gigi74168/openKVM/docs/00-decision-architecture.md

# 00 — Décision d'architecture : ESP32-P4 en 10/100 Mbit/s

Date : 2026-11-12 — statut : **validée**

## Le conflit
- Exigence initiale : RJ45 **Gigabit** + fork du firmware JetKVM Mini (ESP32-P4, MIT).
- L'ESP32-P4 n'a qu'un MAC 10/100 (MII/RMII ; ESP-IDF ne gère que le RMII). Son unique port USB HS
  est réservé à la machine cible, donc pas d'adaptateur USB→GbE.
- Le RV1106 (JetKVM original, GPL-2.0) est **lui aussi** limité à 10/100 (MAC + PHY intégré, RMII).
- Le Gigabit impose un autre SoC (ex. RV1126B : GMAC RGMII 1G) avec DDR + eMMC + BGA, PCB 6 couches
  probable et coût incompatible avec l'objectif < 39 $.

## Décision
- **v1 : ESP32-P4 + PHY 10/100**, fork de `jetkvm/mini` (MIT, copyright d'origine conservé).
- Exigence « RJ45 Gigabit » remplacée par « RJ45 10/100 ».
- Piste **v2 « Pro » Gigabit** (RV1126B + RTL8211F, portage de `jetkvm/kvm` GPL-2.0) : documentée, hors périmètre.

## Pourquoi le Gigabit était voulu : envoi rapide d'ISO
- 100 Mbit/s ≈ 11 Mo/s théoriques → ISO de 5 Go ≈ 8 min (estimation, à mesurer au bring-up).
- Mitigations à étudier (livrables 2, 7 et 8) :
  - slot microSD accessible de l'extérieur pour copier l'ISO directement depuis un PC ;
  - bibliothèque d'ISO persistante sur la carte (on n'envoie une image qu'une fois) ;
  - upload reprenable, en arrière-plan ;
  - mesure du débit SDIO réel du P4 et du débit USB Mass Storage vers la cible.

## Décision complémentaire (2026-11-12) : version sans écran

Le brief initial demandait le même écran IPS 240 × 240 que le Mini. **Cette exigence est abandonnée** à ta demande :
openKVM v1 n'a **aucun écran**.

| Avant | Maintenant |
|---|---|
| Écran IPS 1,54″ ST7789 sur connecteur J7, 6 GPIO | Supprimé, les 6 GPIO sont libres |
| 2 boutons latéraux (navigation, mode) | 1 bouton latéral « FN » (réinitialisation réseau / usine) |
| 1 LED de debug | 1 LED d'alimentation + 1 LED d'état |
| Boîtier ≈ 49,6 × 49,6 × 26,5 mm, capot à fenêtre | ≈ 49,6 × 49,6 × 21,5 mm, capot plein |
| Module d'écran à acheter et à monter à la main | Plus rien hors assemblage JLCPCB, sauf le TC358743 à fournir |

Conséquences :
- L'adresse IP ne s'affiche plus. Le firmware (livrable 8) devra annoncer l'appareil par **mDNS** et par nom d'hôte DHCP.
- Le fork de `jetkvm/mini` devra **retirer le pilote d'écran** et piloter la LED d'état à la place.
- C'est un écart assumé par rapport au Mini, qui garde son écran. En échange : moins cher, plus bas, plus simple à monter.

## Sources
- JetKVM Mini — https://jetkvm.com/blog/introducing-jetkvm-mini
- jetkvm/mini (MIT, ESP-IDF 6.0.2, IP101, TC358743) — https://github.com/jetkvm/mini
- jetkvm/kvm (GPL-2.0) — https://github.com/jetkvm/kvm
- ESP32-P4 Features (Zephyr) — https://docs.zephyrproject.org/latest/boards/espressif/common/soc-esp32p4-features.html
- ESP-IDF esp_eth ESP32-P4 — https://docs.espressif.com/projects/esp-idf/en/v5.4.3/esp32p4/api-reference/network/esp_eth.html
- Rockchip RV1106 Datasheet V1.7 — https://rockchips.net/wp-content/uploads/2025/03/Rockchip-RV1106-Datasheet-V1.7-20231218.pdf
- Forlinx OK1126B-S Hardware Manual — https://docs.forlinx.net/rockchip/ok1126bx-s/OK1126B-S_OK1126BJ-S_User_Hardware_Manual.html
