gigi74168/openKVM/hardware/exports/netlist.csv

Net | Nb | Broches
1V2 | 8 | L2.2 R9.1 C10.1 C12.1 C13.1 FB1.1 FB2.1 FB3.1
3V3 | 49 | L1.2 R6.1 C5.1 C7.1 C8.1 C9.1 R8.1 U1.9 U1.21 U1.62 U1.75 U1.77 U1.96 U1.101 C14.1 C15.1 C16.1 C17.1 C18.1 C19.1 C20.1 C21.1 R11.1 R12.1 U2.4 C47.1 R20.1 R21.1 R23.1 R25.1 R26.1 TP1.1 U8.F4 U8.H7 R34.1 C70.1 C71.1 FB5.1 U9.13 R36.1 R37.1 R40.1 R41.1 C73.1 FB6.1 J4.9 R55.1 Q1.2 R56.1
5V_SYS | 10 | U3.6 U4.6 C3.1 C4.1 U5.4 R5.1 C6.1 U6.4 C11.1 R22.1
BTN_FN | 3 | U1.25 SW1.3 R23.2
CHIP_PU | 4 | U1.103 R20.2 C52.1 TP4.1
CSI_CLK_N | 2 | U1.45 U8.C7
CSI_CLK_P | 2 | U1.44 U8.C8
CSI_D0_N | 2 | U1.42 U8.E7
CSI_D0_P | 2 | U1.43 U8.E8
CSI_D1_N | 2 | U1.46 U8.D7
CSI_D1_P | 2 | U1.47 U8.D8
CSI_REXT | 2 | U1.48 R14.1
DSI_REXT | 2 | U1.34 R13.1
EN_1V2 | 2 | U6.1 R8.2
EN_3V3 | 2 | U5.1 R5.2
EN_DCDC | 2 | U1.79 U2.1
ETH_AVDD33 | 4 | U9.31 FB6.2 C74.1 C75.1
ETH_CLKO | 2 | U9.14 R39.1
ETH_CT_RX | 2 | J4.5 C81.1
ETH_CT_TX | 2 | J4.4 C80.1
ETH_ISET | 2 | U9.25 R38.1
ETH_LED0 | 3 | U9.11 R37.2 R42.2
ETH_LED3 | 2 | U9.12 R43.1
ETH_LEDG_K | 2 | J4.10 R42.1
ETH_LEDY_A | 2 | J4.12 R43.2
ETH_REGOUT | 3 | U9.28 C76.1 C77.1
ETH_RMII_SEL | 2 | U9.4 R36.2
ETH_RX_N | 2 | U9.26 J4.6
ETH_RX_P | 2 | U9.27 J4.3
ETH_TX_N | 2 | U9.29 J4.2
ETH_TX_P | 2 | U9.30 J4.1
ETH_X1 | 3 | U9.2 Y3.1 C78.1
ETH_X2 | 3 | U9.3 Y3.3 C79.1
FB_1V2 | 4 | U6.5 R9.2 R10.1 C10.2
FB_3V3 | 4 | U5.5 R6.2 R7.1 C5.2
FB_DCDC | 5 | U1.78 U2.5 R15.2 R16.1 C46.2
FLASH_CK | 2 | U1.32 U7.6
FLASH_CS | 3 | U1.27 U7.1 R19.2
FLASH_D | 2 | U1.33 U7.5
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
VDD_BAT | 4 | U1.102 R11.2 C22.1 C23.1
VDD_HP | 13 | U1.26 U1.54 U1.76 U1.91 C27.1 C28.1 C29.1 C30.1 C31.1 L3.2 R15.1 C46.1 C48.1
VDD_USBPHY | 5 | U1.51 R12.2 C24.1 C25.1 C26.1
XTAL_A | 3 | Y1.1 R17.1 C49.1
XTAL_B | 3 | Y1.3 R18.1 C50.1
XTAL_N | 2 | U1.99 R18.2
XTAL_P | 2 | U1.100 R17.2
