gigi74168/openKVM/hardware/exports/placement.csv

ref | face | x_mm | y_mm | rotation
C1 | dessus | 43.00 | 9.60 | 270
C10 | dessous | 13.00 | 35.60 | 180
C11 | dessus | 11.40 | 35.00 | 90
C12 | dessus | 14.40 | 35.40 | 180
C13 | dessus | 14.00 | 33.60 | 0
C14 | dessous | 33.20 | 31.80 | 90
C15 | dessous | 20.00 | 37.00 | 270
C16 | dessous | 21.60 | 37.80 | 270
C17 | dessous | 27.00 | 37.80 | 270
C18 | dessous | 27.80 | 33.60 | 90
C19 | dessous | 35.20 | 32.60 | 0
C2 | dessus | 9.20 | 26.20 | 90
C20 | dessous | 34.00 | 28.80 | 0
C21 | dessous | 34.80 | 30.80 | 270
C22 | dessous | 29.40 | 37.60 | 180
C23 | dessous | 25.20 | 31.40 | 90
C24 | dessus | 18.80 | 27.80 | 180
C25 | dessus | 17.40 | 29.20 | 180
C26 | dessous | 23.20 | 24.40 | 0
C27 | dessous | 19.80 | 26.20 | 90
C28 | dessous | 23.00 | 37.80 | 270
C29 | dessous | 25.60 | 37.80 | 270
C3 | dessous | 7.40 | 41.20 | 0
C30 | dessus | 36.40 | 42.40 | 270
C31 | dessous | 35.20 | 24.80 | 0
C32 | dessous | 27.80 | 28.20 | 270
C33 | dessous | 17.20 | 33.20 | 180
C34 | dessous | 36.80 | 29.40 | 0
C35 | dessous | 17.80 | 27.80 | 180
C36 | dessous | 25.20 | 29.20 | 90
C37 | dessous | 17.20 | 34.60 | 180
C38 | dessous | 18.20 | 26.00 | 90
C39 | dessous | 27.60 | 30.40 | 270
C4 | dessus | 12.60 | 41.20 | 0
C40 | dessous | 18.60 | 37.00 | 270
C41 | dessous | 23.80 | 22.80 | 180
C42 | dessus | 19.20 | 37.00 | 270
C43 | dessus | 21.20 | 23.20 | 270
C44 | dessous | 16.80 | 36.00 | 180
C45 | dessous | 24.20 | 40.00 | 270
C46 | dessus | 28.40 | 40.00 | 0
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
TP3 | dessous | 19.60 | 34.60 | 0
TP4 | dessous | 32.40 | 38.00 | 0
TP5 | dessous | 17.20 | 31.20 | 0
TP6 | dessous | 28.40 | 42.40 | 0
U1 | dessus | 26.50 | 31.00 | 180
U10 | dessus | 22.75 | 12.50 | 0
U11 | dessus | 25.75 | 12.50 | 0
U12 | dessus | 29.20 | 12.50 | 0
U13 | dessus | 39.50 | 10.20 | 0
U14 | dessus | 9.90 | 31.00 | 90
U2 | dessus | 33.50 | 39.50 | 0
U3 | dessus | 6.60 | 42.30 | 0
U4 | dessus | 10.20 | 42.30 | 0
U5 | dessus | 4.60 | 38.30 | 0
U6 | dessus | 12.60 | 38.30 | 0
U7 | dessus | 37.00 | 33.00 | 0
U8 | dessus | 26.00 | 18.50 | 270
U9 | dessus | 13.60 | 25.20 | 0
Y1 | dessus | 18.80 | 32.80 | 90
Y2 | dessus | 20.40 | 18.50 | 0
Y3 | dessus | 18.60 | 24.60 | 90
