gigi74168/openKVM/hardware/exports/openkvm-schema.pdf

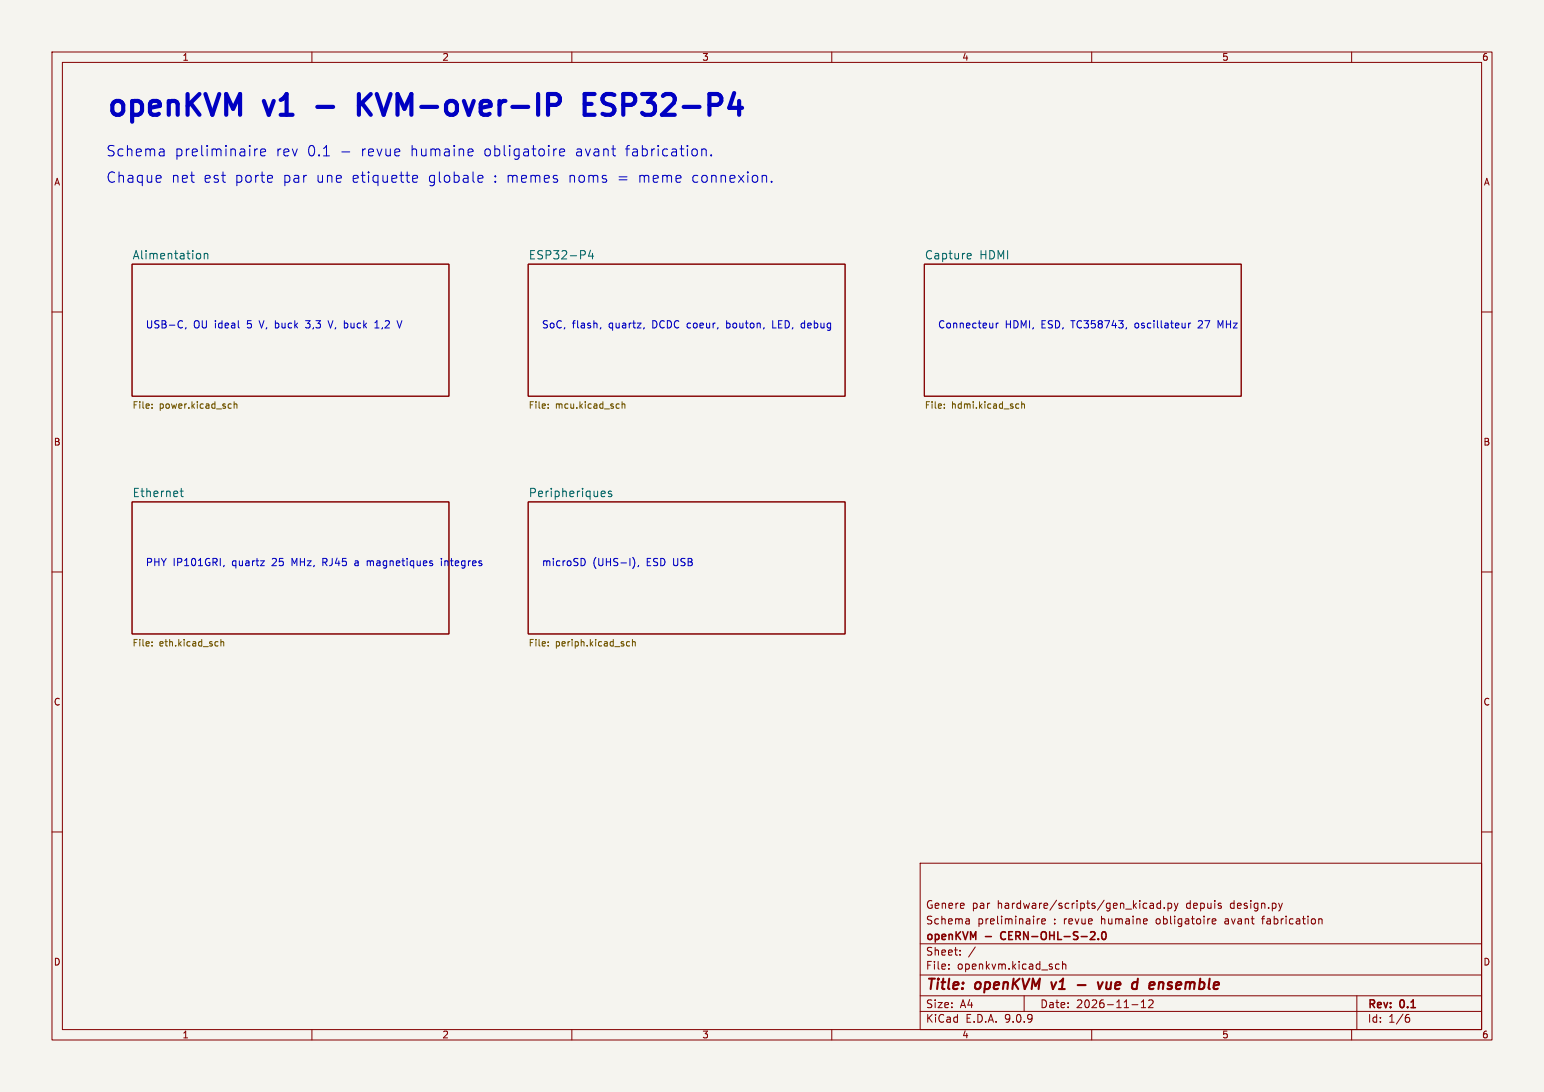
[picture p15: page 1]

USB-C, OU ideal 5 V, buck 3,3 V, buck 1,2 V

Id: 1/6 Title: openKVM v1 - vue d ensemble

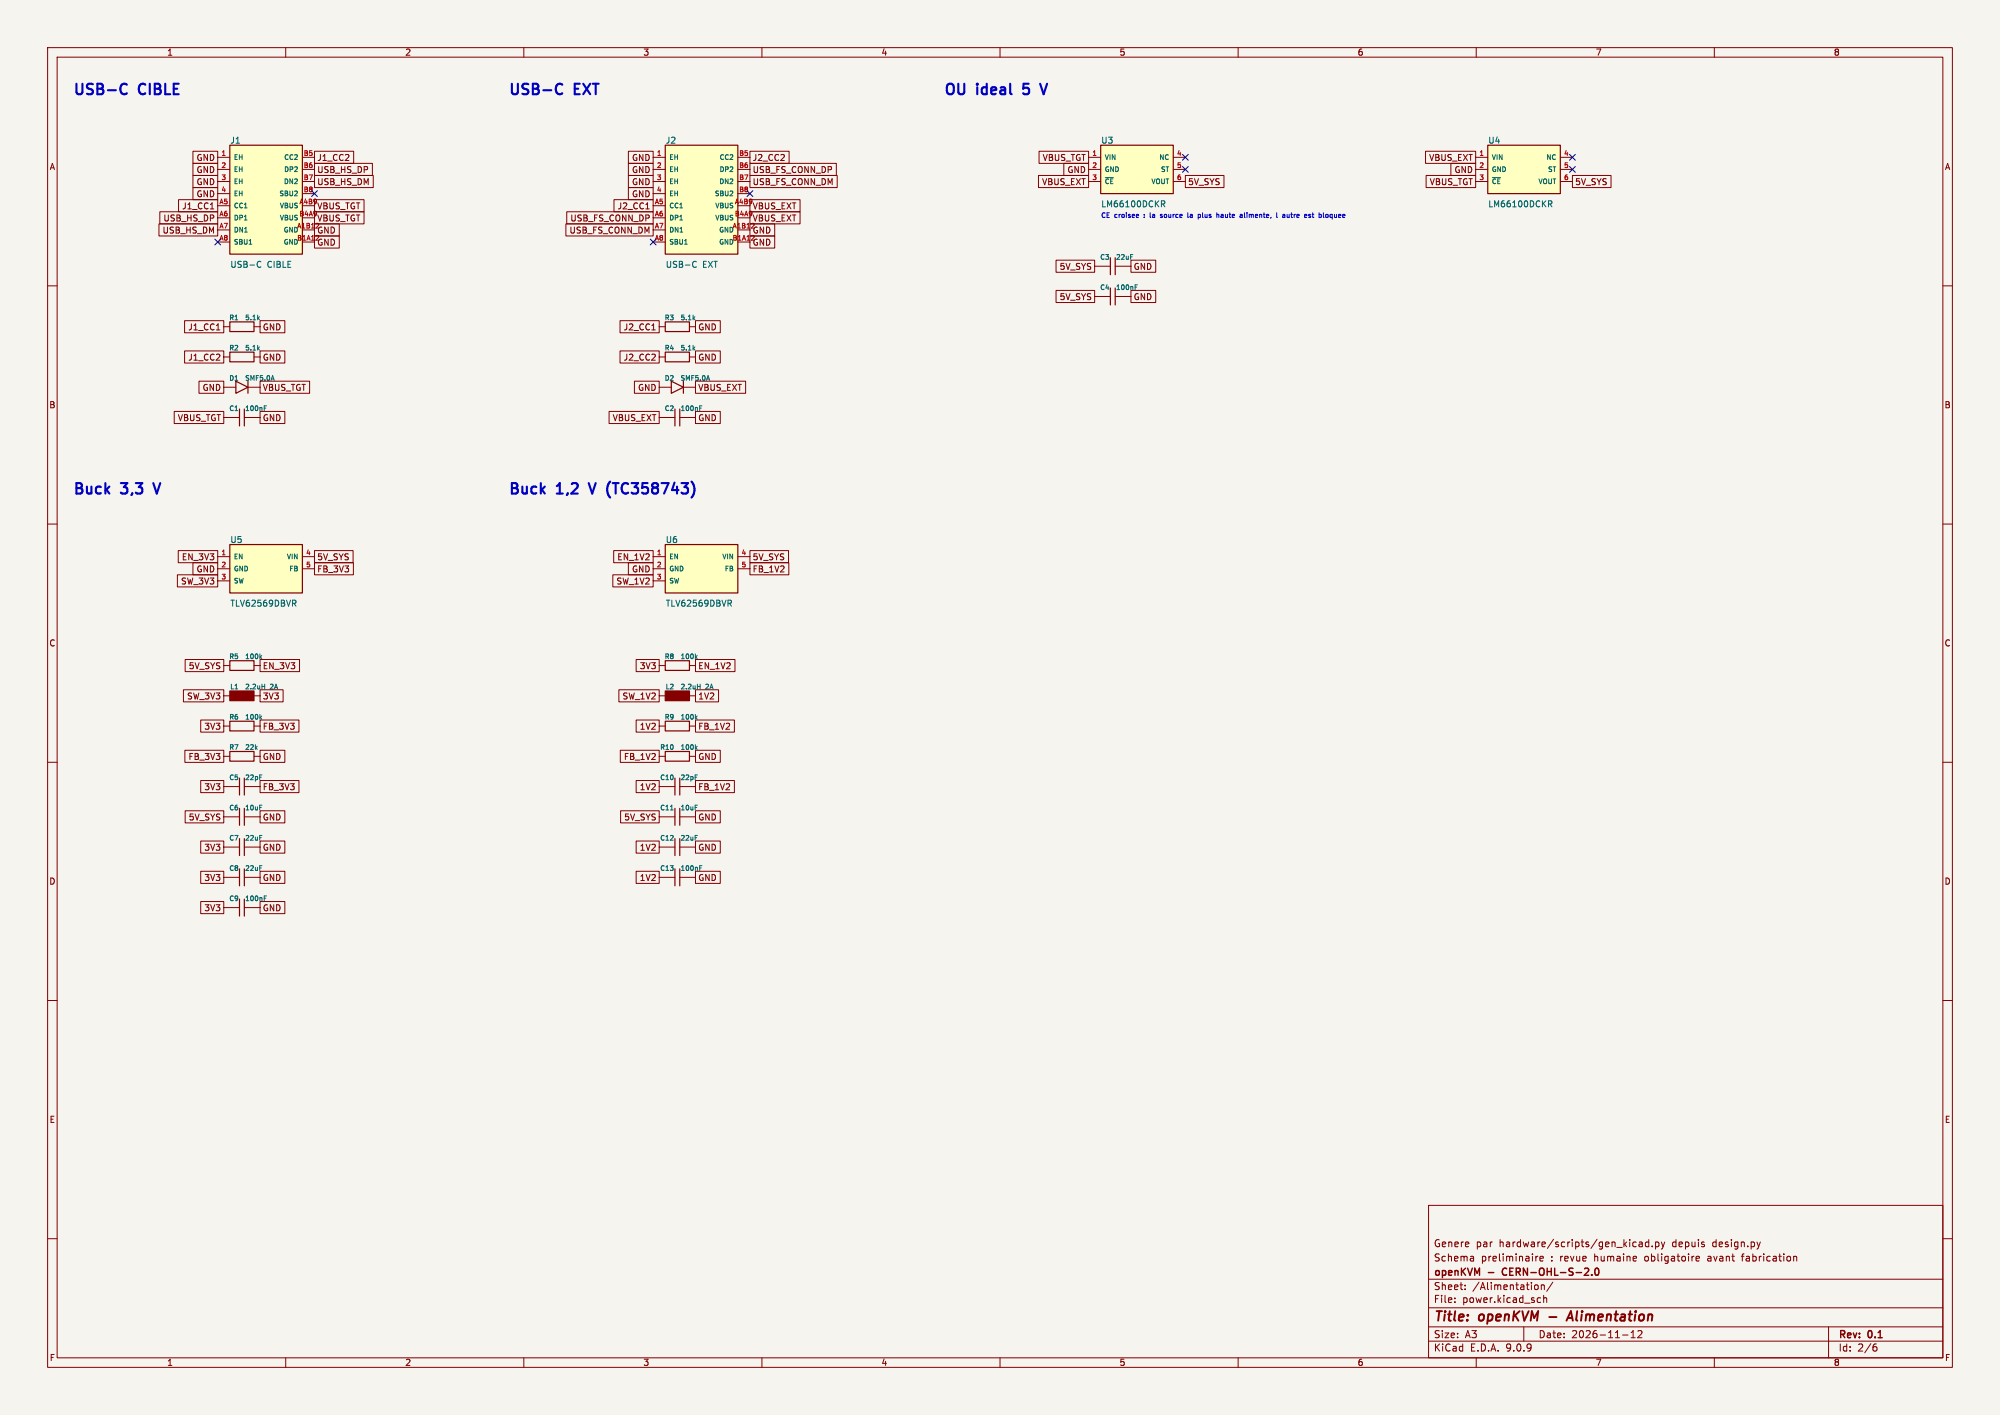
[picture p16: page 2]

J1_CC1 GND GND GND GND

Id: 2/6 Title: openKVM - Alimentation

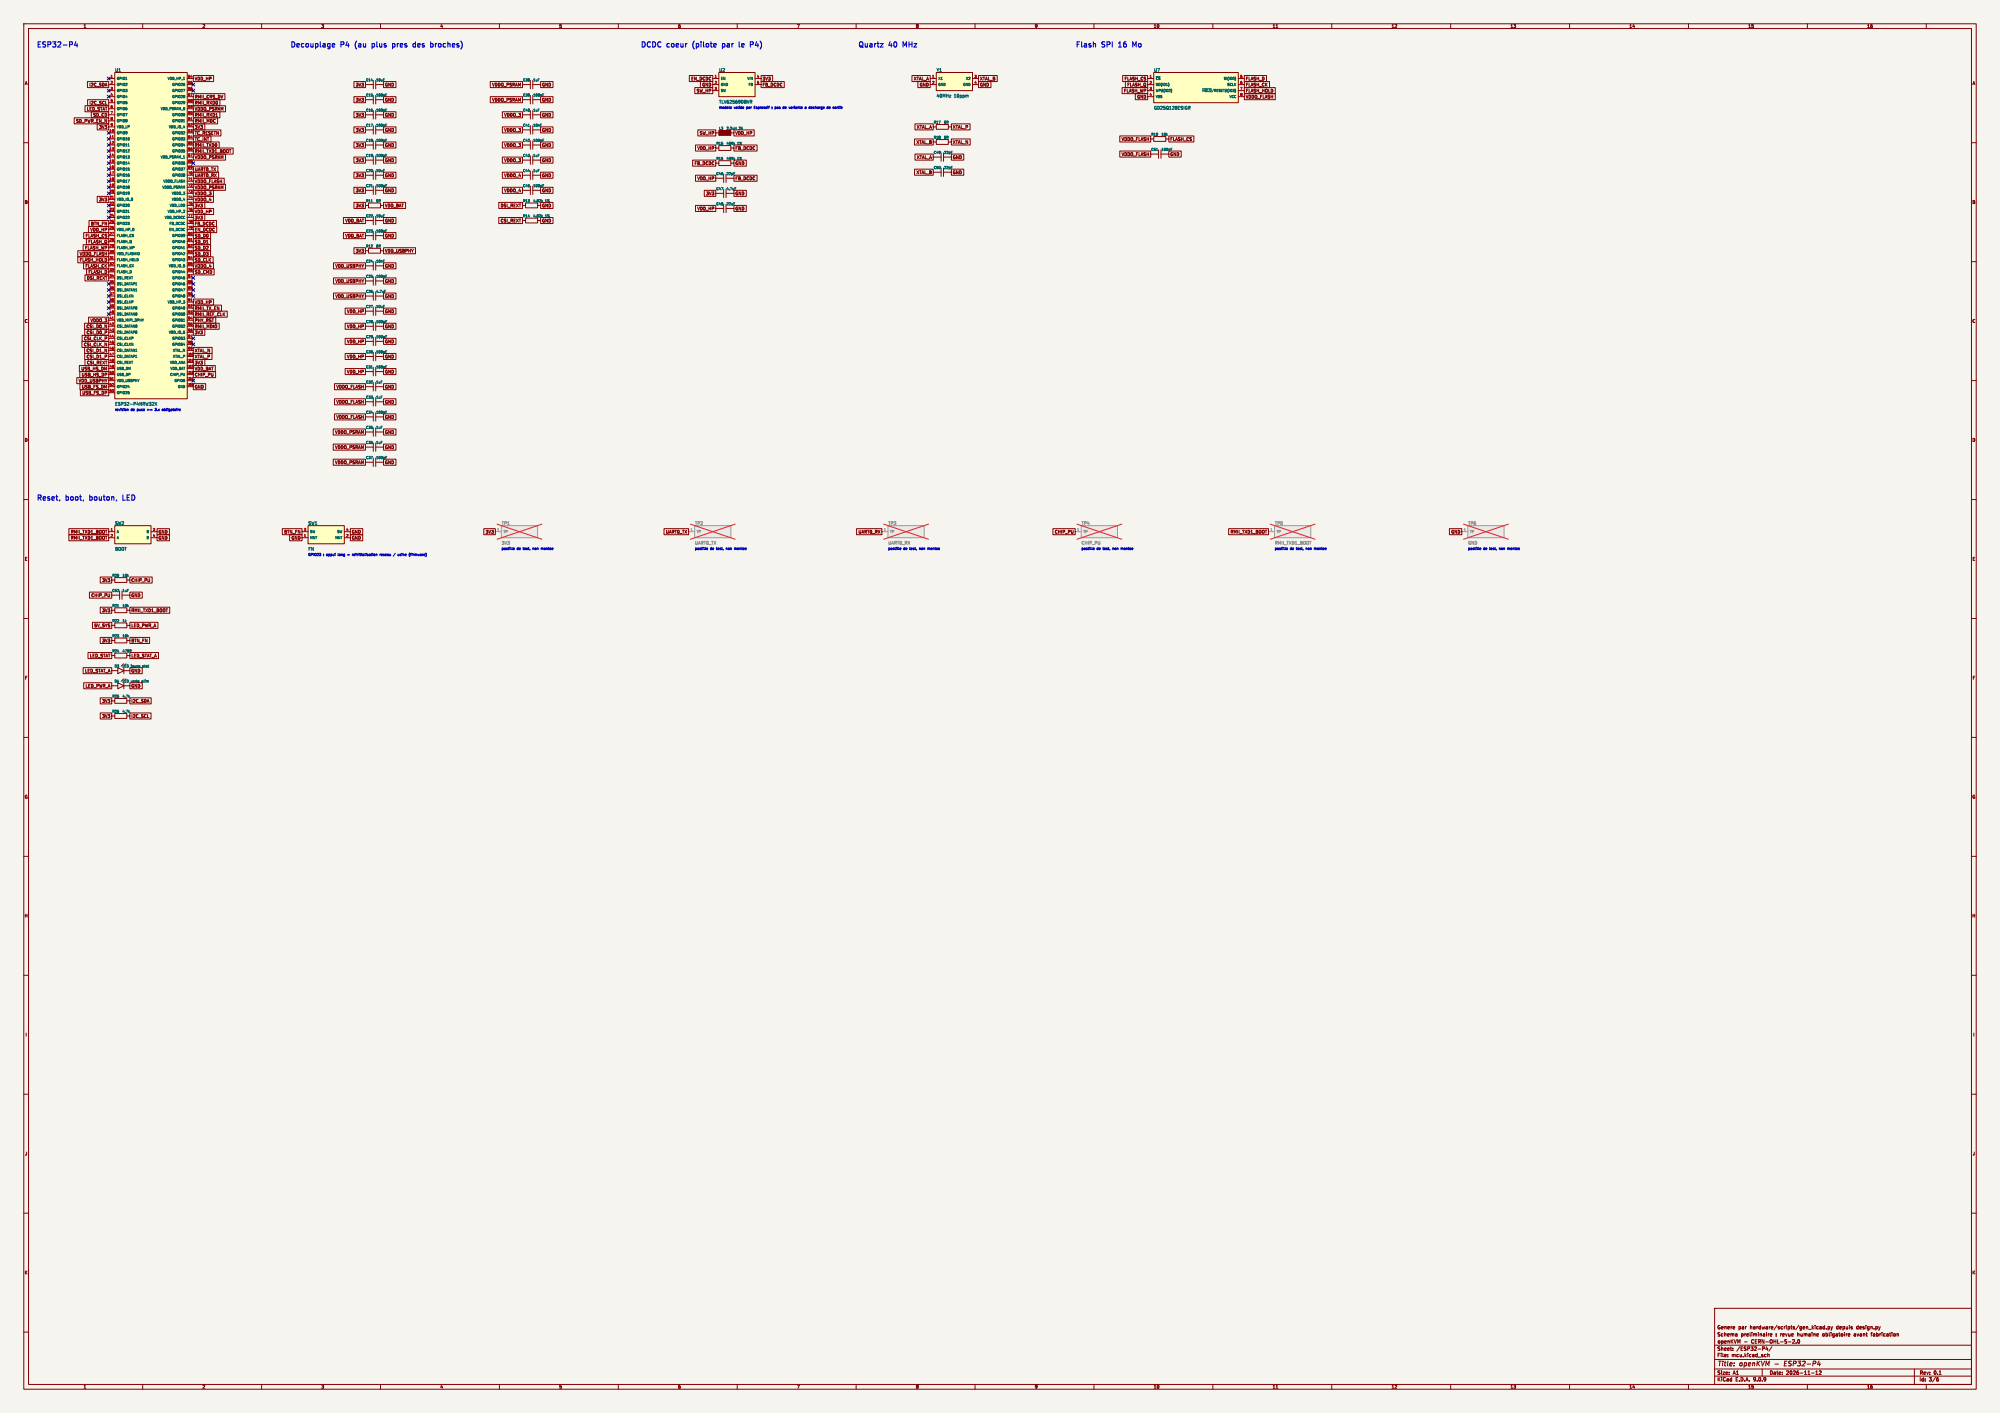
[picture p17: page 3]

DCDC coeur (pilote par le P4)
3V3 FB_DCDC

8 U7 GD25Q128ESIGR
~{CS} 1 SO(IO1) 2 WP#(IO2) 3 VSS

XTAL_A GND GND GND GND

Reset, boot, bouton, LED

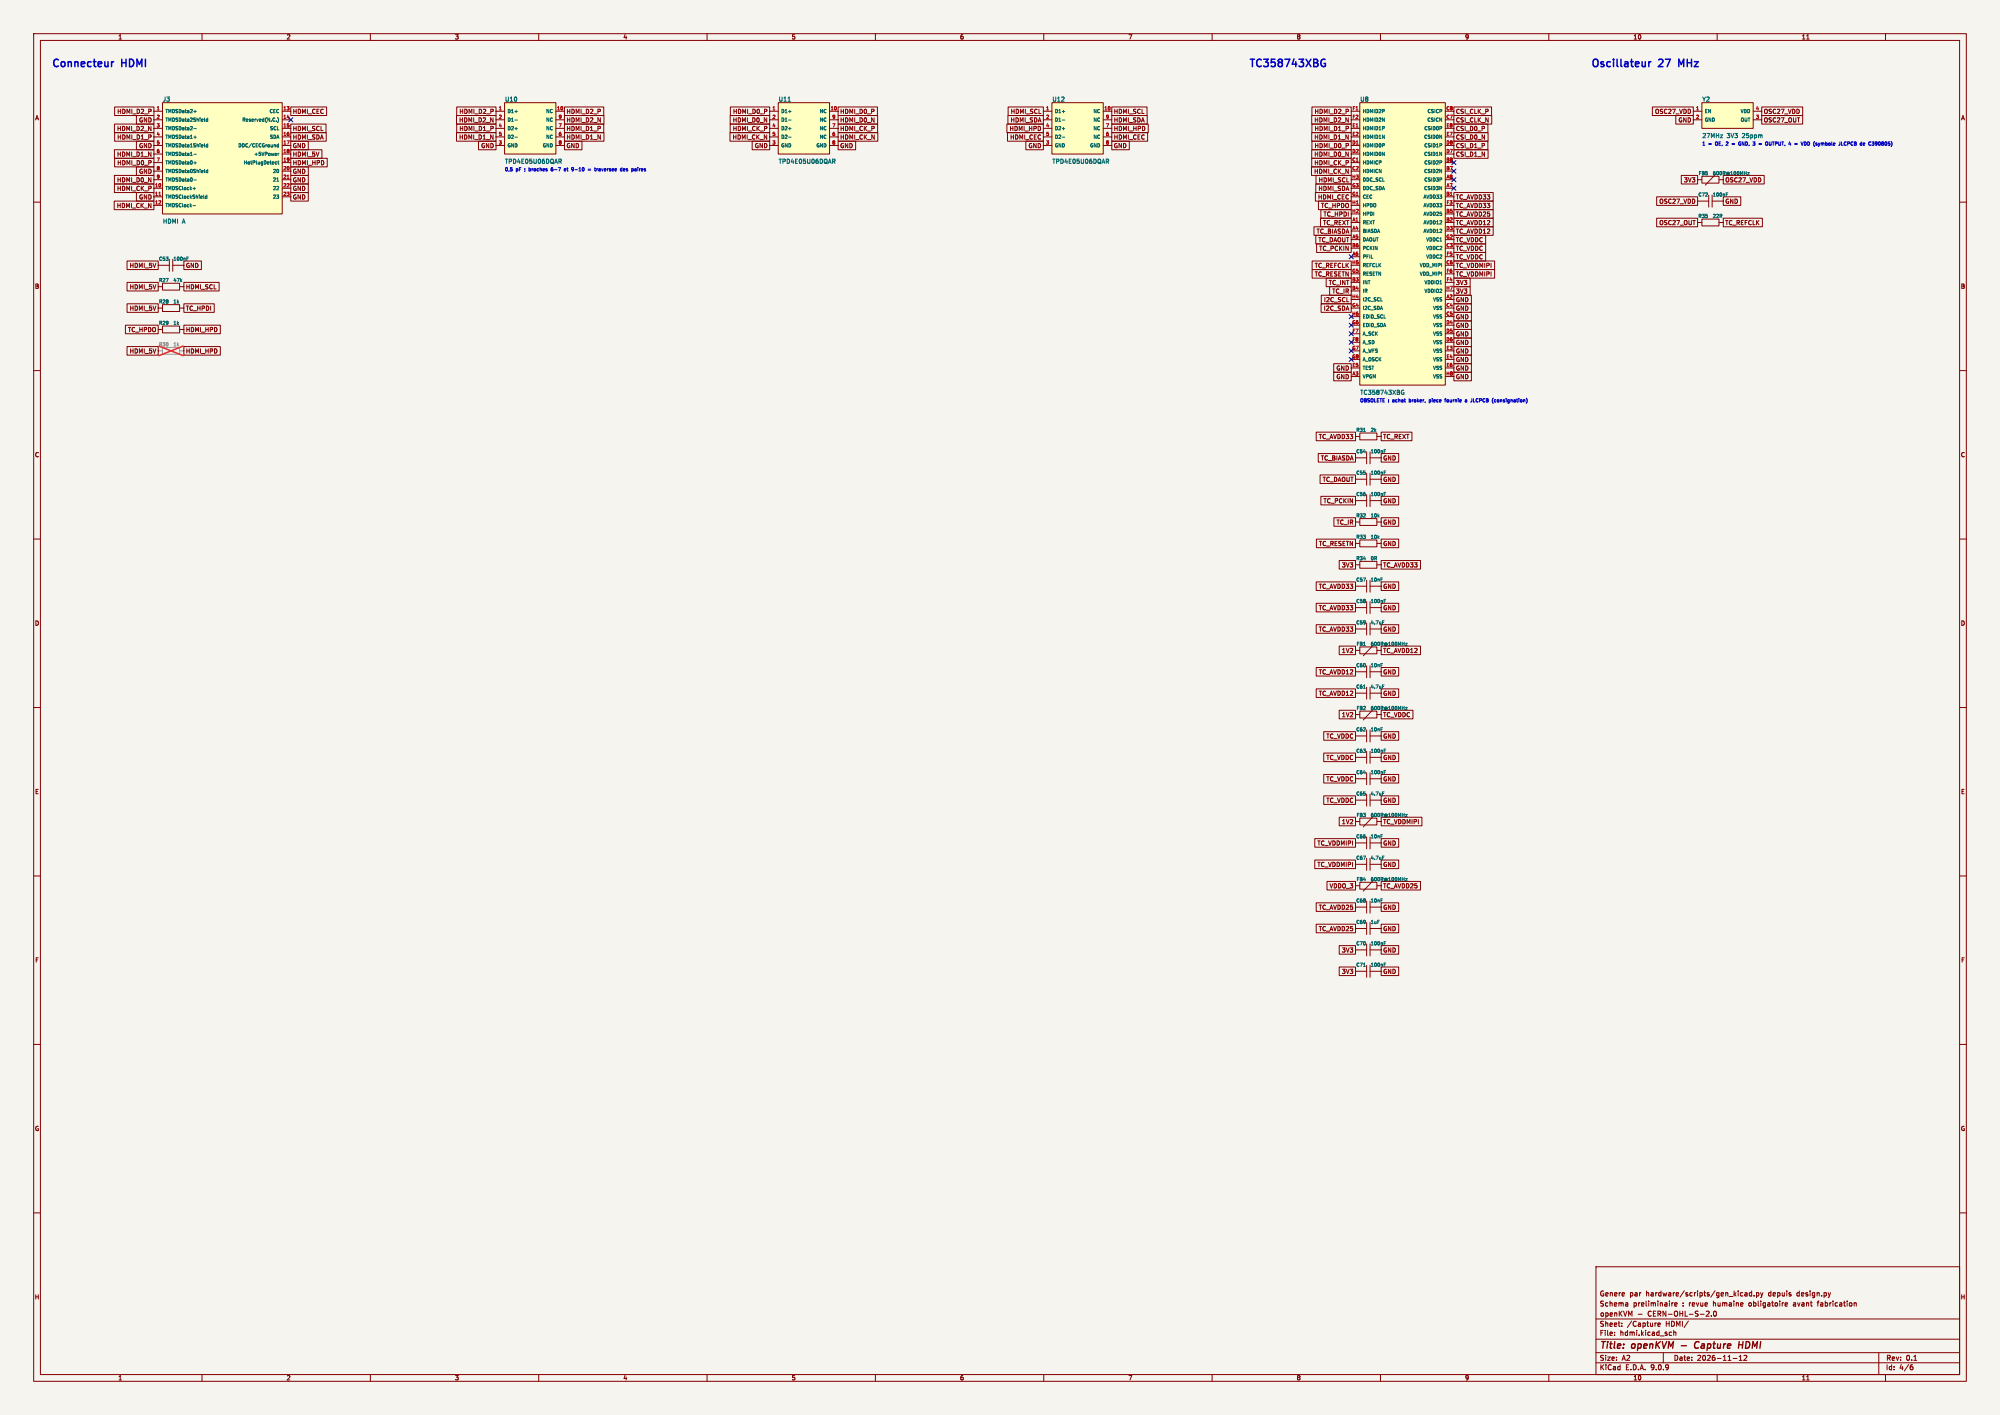
[picture p18: page 4]

HDMI_5V HDMI_HPD GND GND GND GND

3V3 GND
A2 VSS C4 VSS C5 VSS D4 VSS D5 VSS D6 VSS

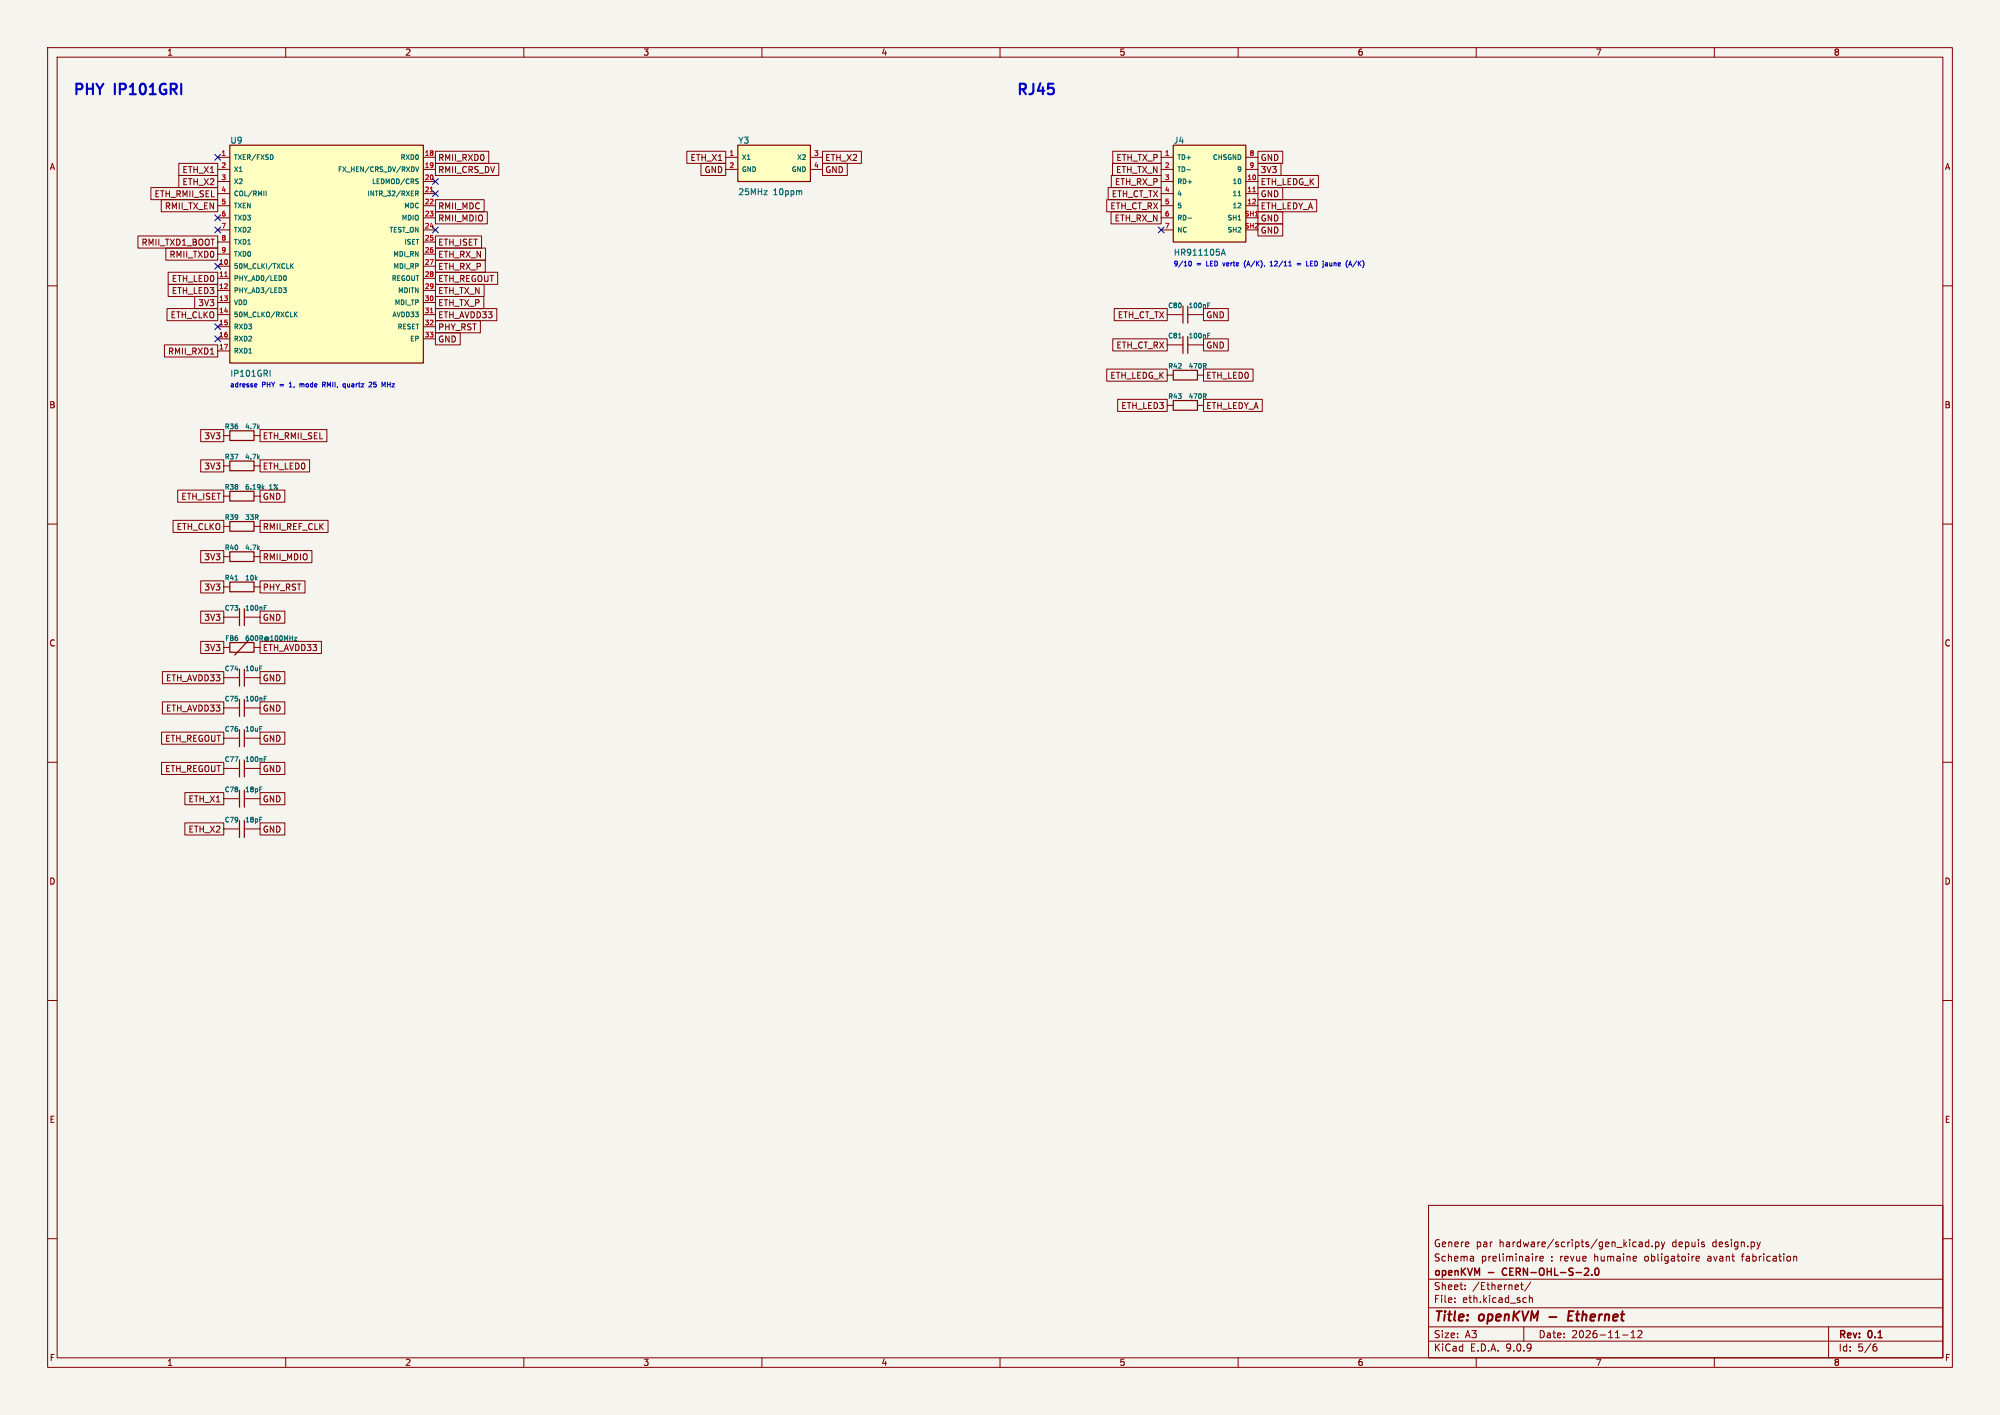
[picture p19: page 5]

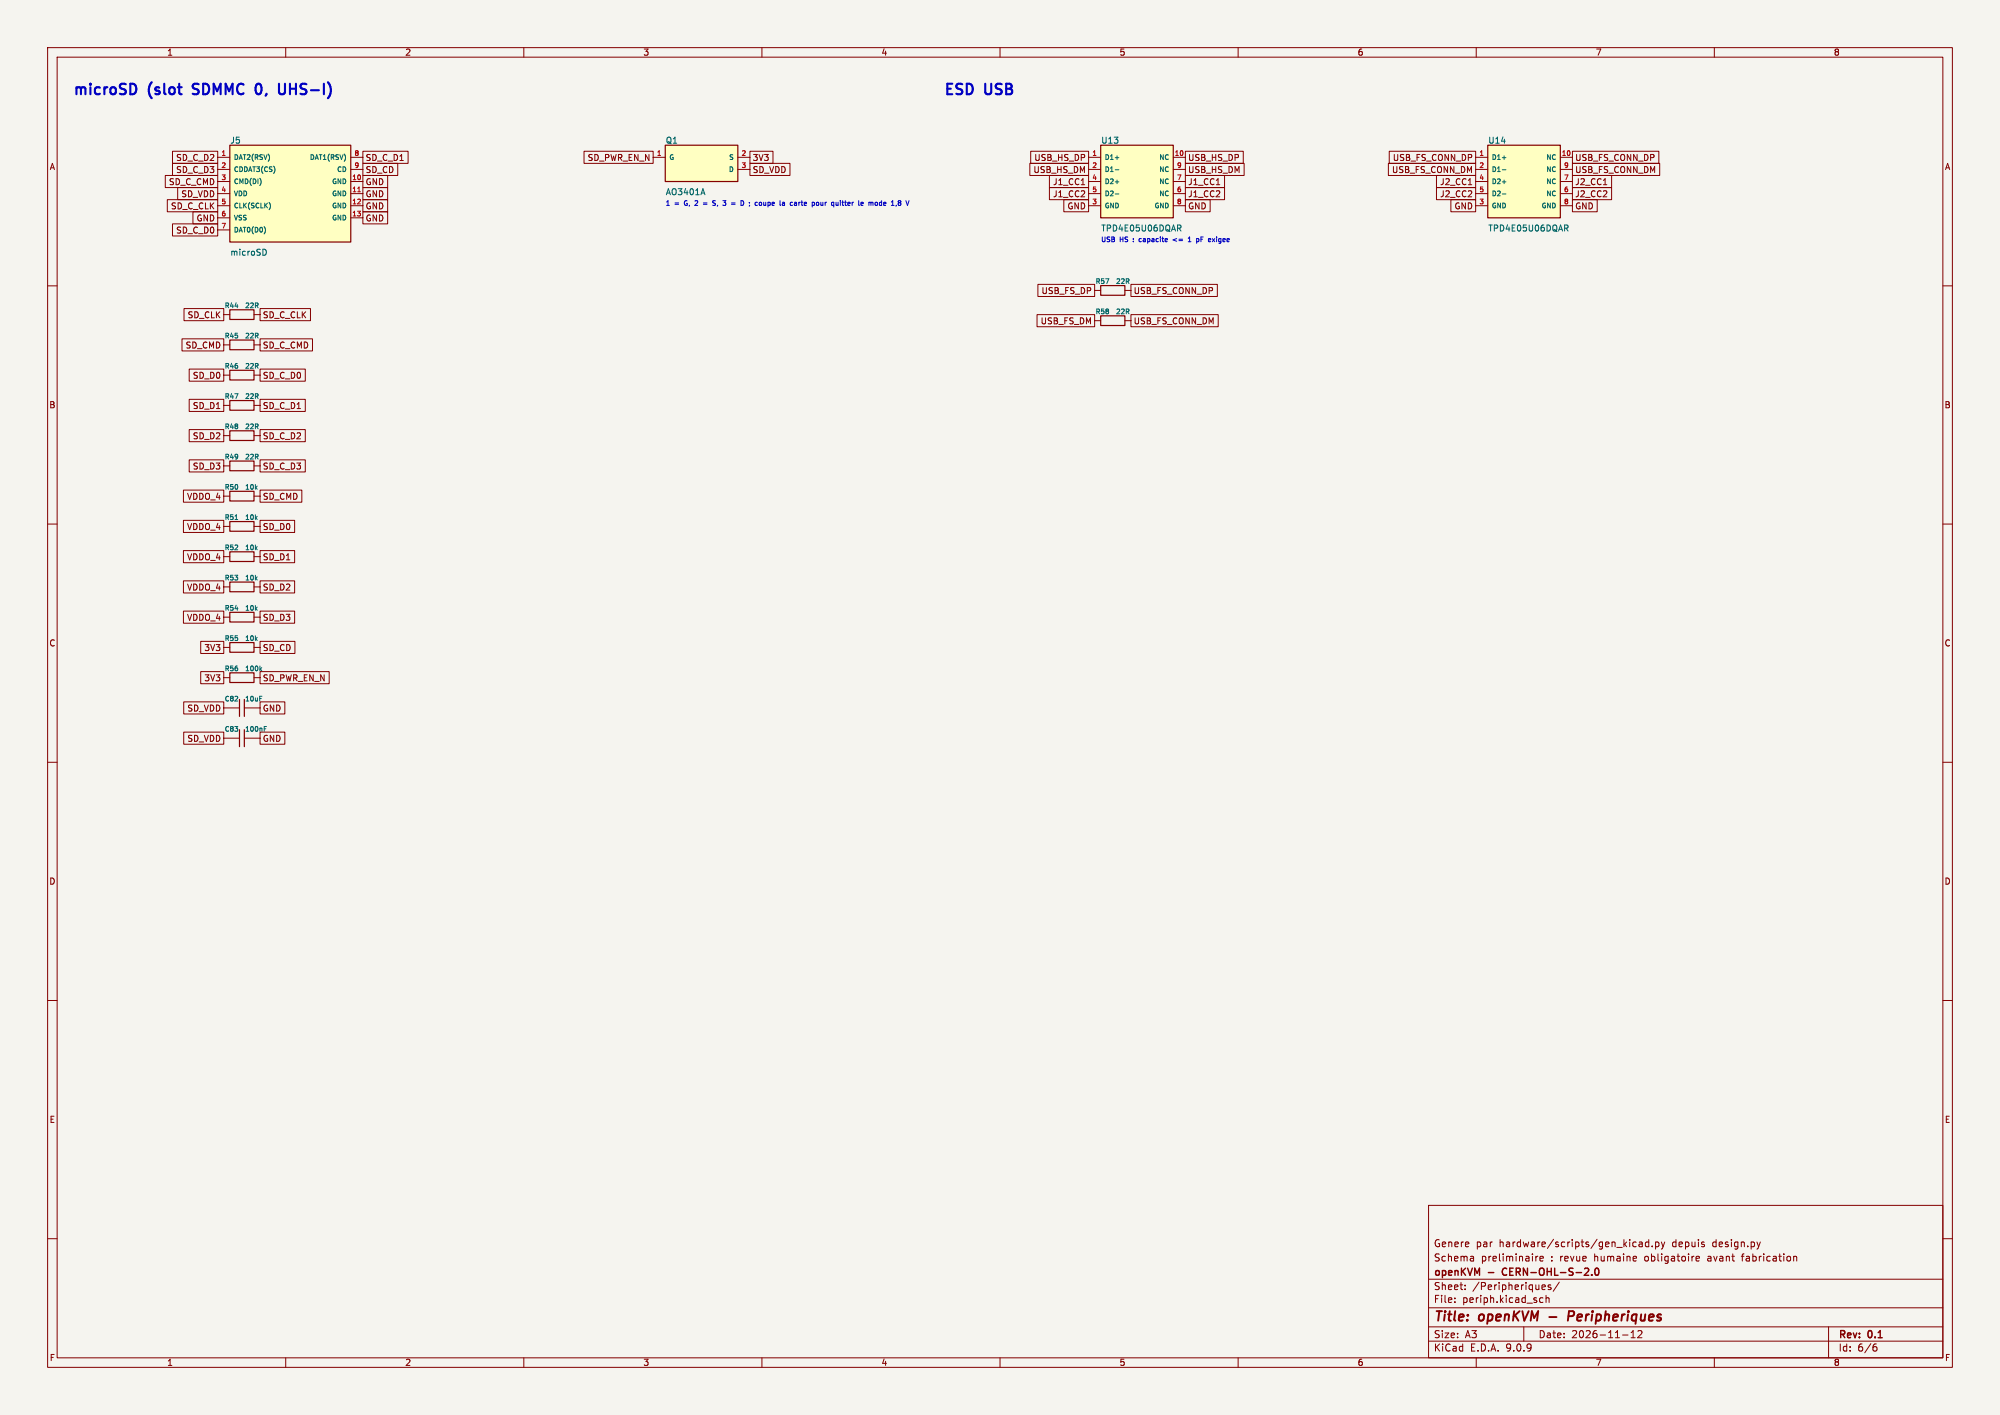
[picture p20: page 6]

Id: 6/6 Title: openKVM - Peripheriques
