gigi74168/openKVM/hardware/openkvm.kicad_pcb

## KiCad design hardware/openkvm.kicad_pcb (2026-11-13)

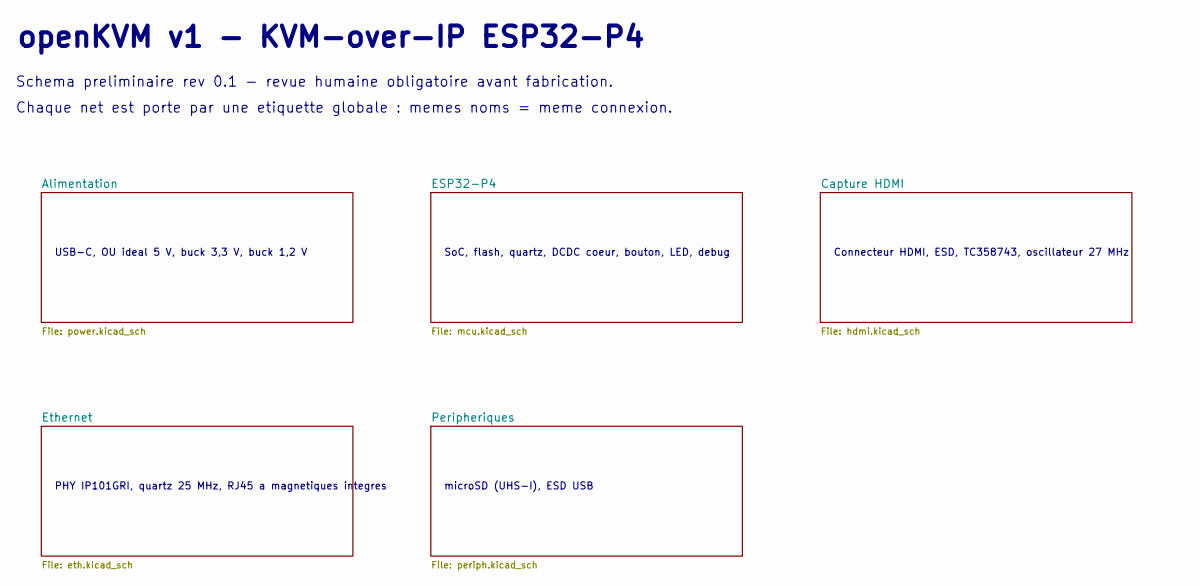
[picture p21: schematic openkvm.kicad_sch, openKVM v1 - vue d ensemble]

Notes on the sheet:
openKVM v1 - KVM-over-IP ESP32-P4
Schema preliminaire rev 0.1 - revue humaine obligatoire avant fabrication.
Chaque net est porte par une etiquette globale : memes noms = meme connexion.
USB-C, OU ideal 5 V, buck 3,3 V, buck 1,2 V
SoC, flash, quartz, DCDC coeur, bouton, LED, debug
Connecteur HDMI, ESD, TC358743, oscillateur 27 MHz
PHY IP101GRI, quartz 25 MHz, RJ45 a magnetiques integres
microSD (UHS-I), ESD USB

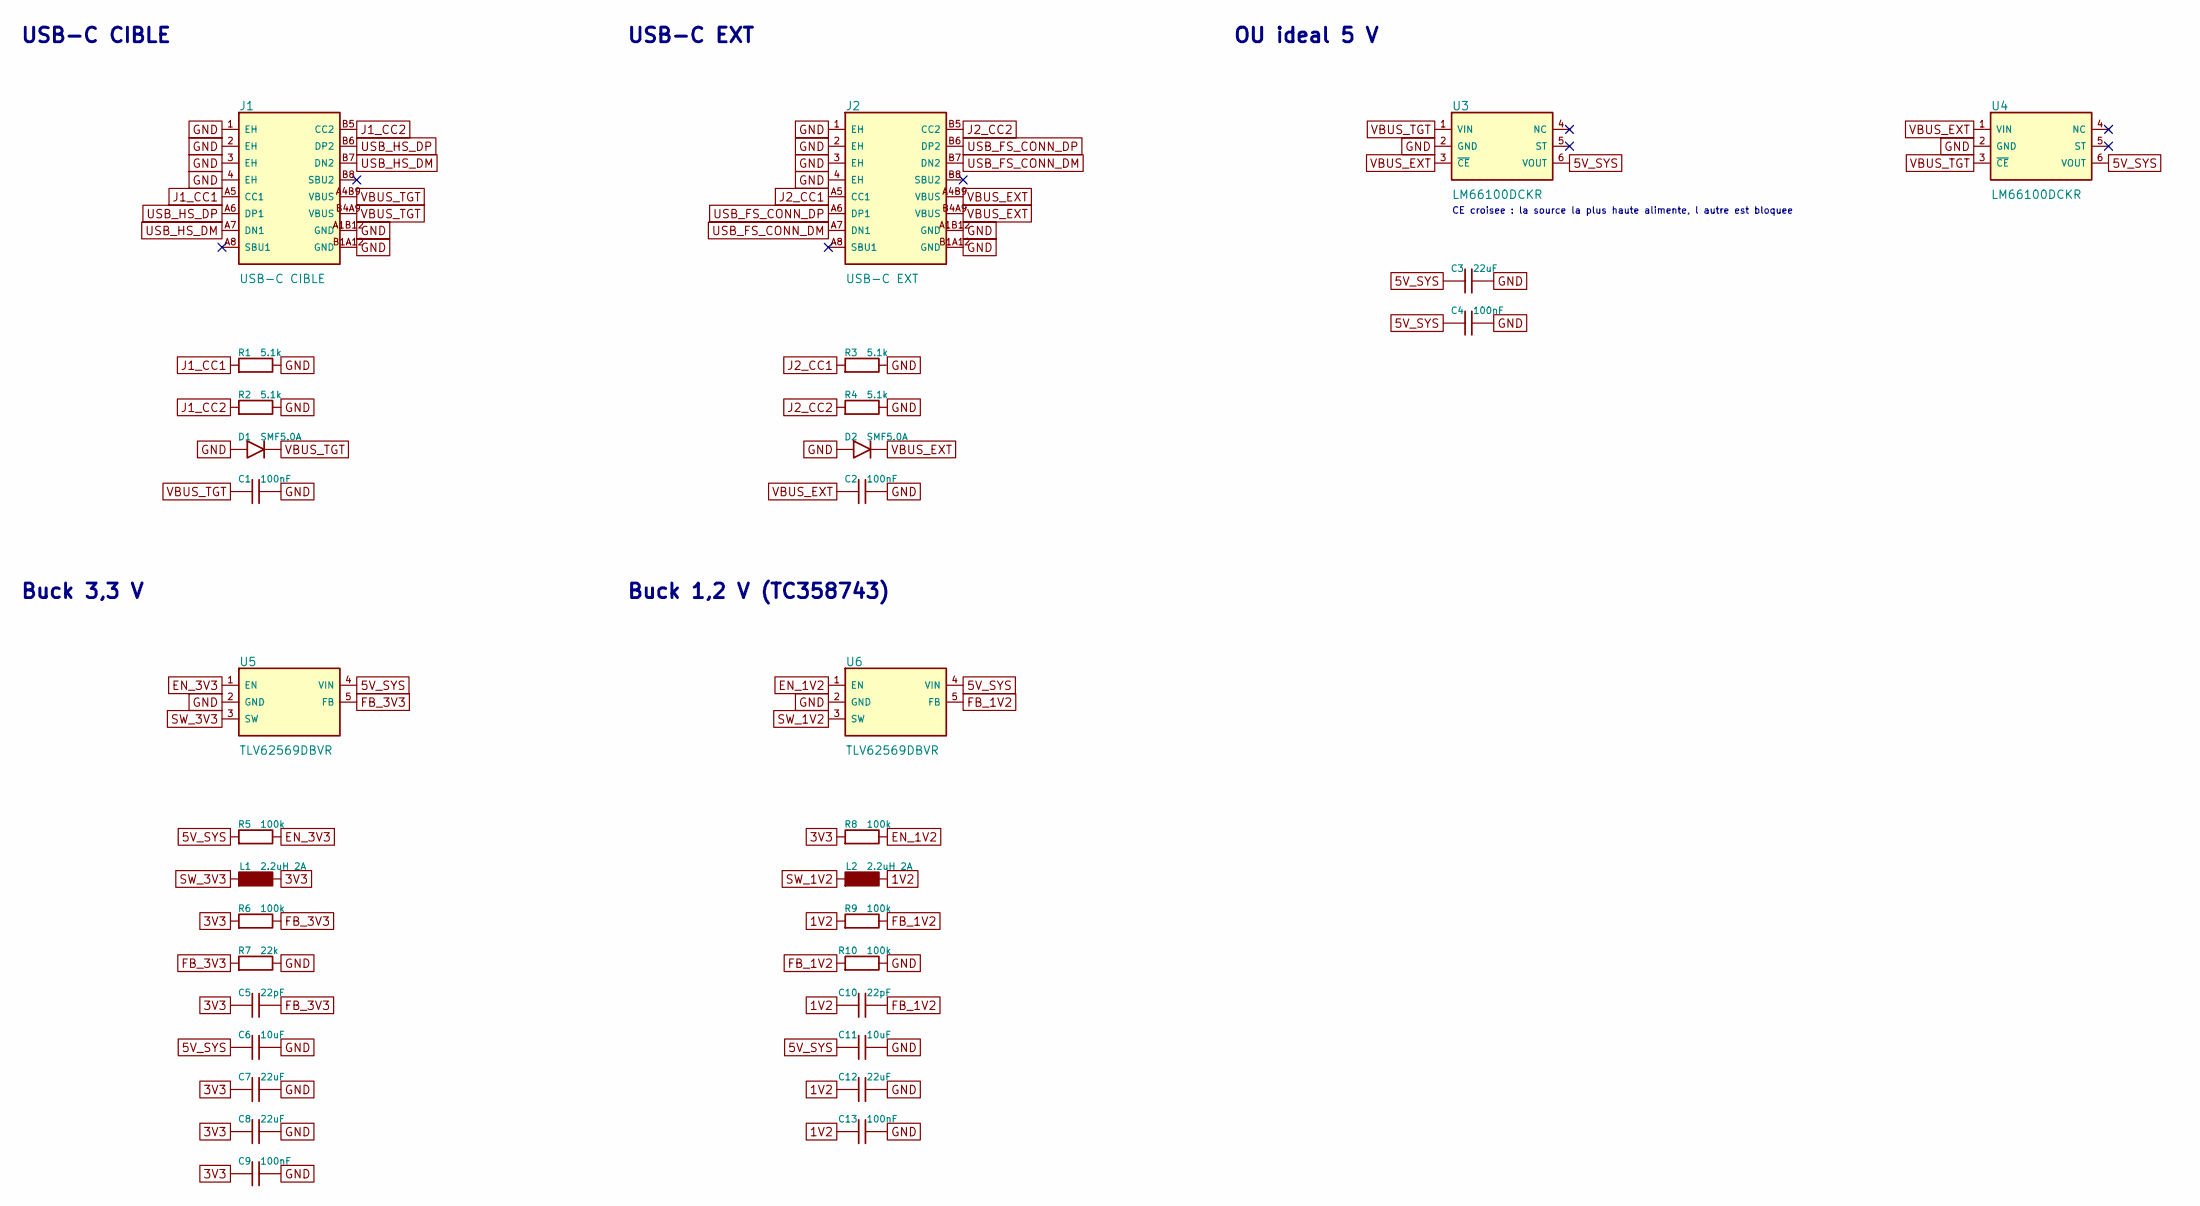
[picture p22: schematic power.kicad_sch, openKVM - Alimentation]

Parts:
C1, C2, C4, C9, C13: 100nF; C_0402_1005Metric; MPN CL05B104KO5NNNC; LCSC C1525
C3, C7, C8, C12: 22uF; C_0805_2012Metric; MPN CL21A226MAQNNNE; LCSC C45783
C5, C10: 22pF; C_0402_1005Metric; MPN 0402CG220J500NT; LCSC C1555
C6, C11: 10uF; C_0603_1608Metric; MPN CL10A106KP8NNNC; LCSC C19702
D1, D2: SMF5.0A; SOD-123FL_L2.7-W1.8-LS3.8-RD; MPN SMF5.0A; LCSC C19077497
J1: USB-C CIBLE; USB-C_SMD-TYPE-C-31-M-12_1; MPN TYPE-C-31-M-12; LCSC C165948
J2: USB-C EXT; USB-C_SMD-TYPE-C-31-M-12_1; MPN TYPE-C-31-M-12; LCSC C165948
L1, L2: 2.2uH 2A; IND-SMD_L3.0-W3.0; MPN SWPA3015S2R2MT; LCSC C43389
R1, R2, R3, R4: 5.1k; R_0402_1005Metric; MPN 0402WGF5101TCE; LCSC C25905
R5, R6, R8, R9, R10: 100k; R_0402_1005Metric; MPN 0402WGF1003TCE; LCSC C25741
R7: 22k; R_0402_1005Metric; MPN 0402WGF2202TCE; LCSC C25768
U3, U4: LM66100DCKR; SC-70-6_L2.0-W1.3-P0.65-LS2.1-BL; MPN LM66100DCKR; LCSC C2869734
U5, U6: TLV62569DBVR; SOT-23-5_L3.0-W1.7-P0.95-LS2.8-BR; MPN TLV62569DBVR; LCSC C141836

Connections:
1V2: C10.1, C12.1, C13.1, L2.2, R9.1; also elsewhere on the board
3V3: C5.1, C7.1, C8.1, C9.1, L1.2, R6.1, R8.1; also elsewhere on the board
5V_SYS: C3.1, C4.1, C6.1, C11.1, R5.1, U3.6 (VOUT), U4.6 (VOUT), U5.4 (VIN), U6.4 (VIN); also elsewhere on the board
EN_1V2: R8.2, U6.1 (EN)
EN_3V3: R5.2, U5.1 (EN)
FB_1V2: C10.2, R9.2, R10.1, U6.5 (FB)
FB_3V3: C5.2, R6.2, R7.1, U5.5 (FB)
GND: C1.2, C2.2, C3.2, C4.2, C6.2, C7.2, C8.2, C9.2, C11.2, C12.2, C13.2, D1.2, D2.2, J1.1 (EH), J1.2 (EH), J1.3 (EH), J1.4 (EH), J1.A1B12 (GND), J1.B1A12 (GND), J2.1 (EH), J2.2 (EH), J2.3 (EH), J2.4 (EH), J2.A1B12 (GND), J2.B1A12 (GND), R1.2, R2.2, R3.2, R4.2, R7.2, R10.2, U3.2 (GND), U4.2 (GND), U5.2 (GND), U6.2 (GND); also elsewhere on the board
J1_CC1: J1.A5 (CC1), R1.1; also elsewhere on the board
J1_CC2: J1.B5 (CC2), R2.1; also elsewhere on the board
J2_CC1: J2.A5 (CC1), R3.1; also elsewhere on the board
J2_CC2: J2.B5 (CC2), R4.1; also elsewhere on the board
SW_1V2: L2.1, U6.3 (SW)
SW_3V3: L1.1, U5.3 (SW)
USB_FS_CONN_DM: J2.A7 (DN1), J2.B7 (DN2); also elsewhere on the board
USB_FS_CONN_DP: J2.A6 (DP1), J2.B6 (DP2); also elsewhere on the board
USB_HS_DM: J1.A7 (DN1), J1.B7 (DN2); also elsewhere on the board
USB_HS_DP: J1.A6 (DP1), J1.B6 (DP2); also elsewhere on the board
VBUS_EXT: C2.1, D2.1, J2.A4B9 (VBUS), J2.B4A9 (VBUS), U3.3 (~CE), U4.1 (VIN)
VBUS_TGT: C1.1, D1.1, J1.A4B9 (VBUS), J1.B4A9 (VBUS), U3.1 (VIN), U4.3 (~CE)

Notes on the sheet:
USB-C CIBLE
USB-C EXT
OU ideal 5 V
CE croisee : la source la plus haute alimente, l autre est bloquee
Buck 3,3 V
Buck 1,2 V (TC358743)

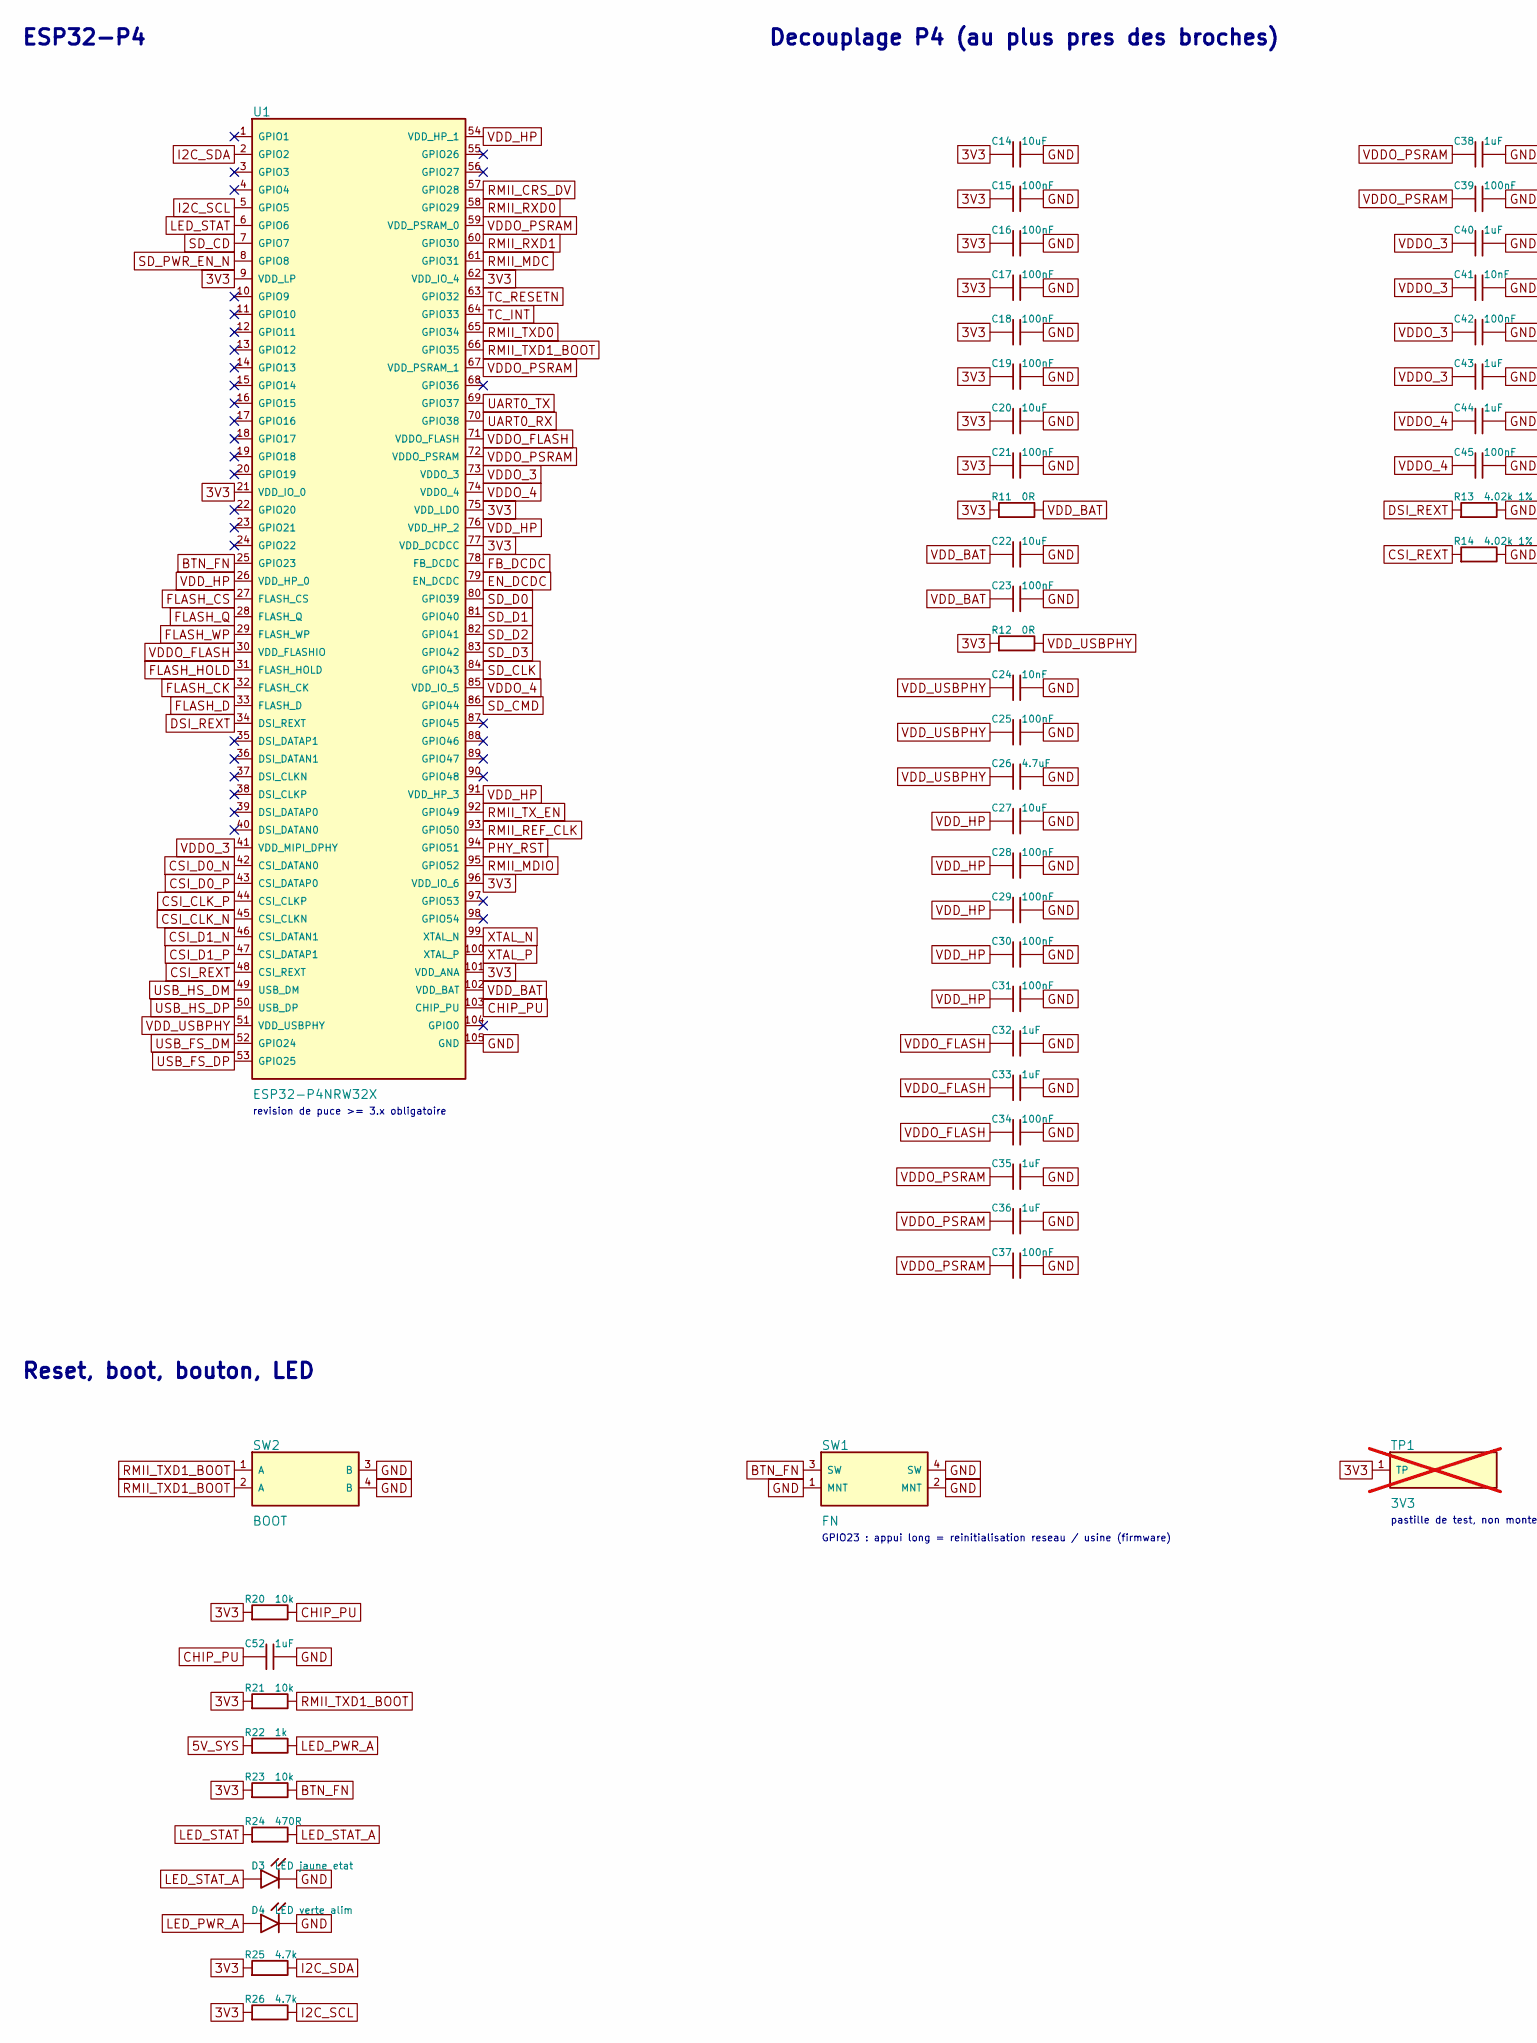
[picture p23: schematic mcu.kicad_sch, openKVM - ESP32-P4, part in row 1, column 1]

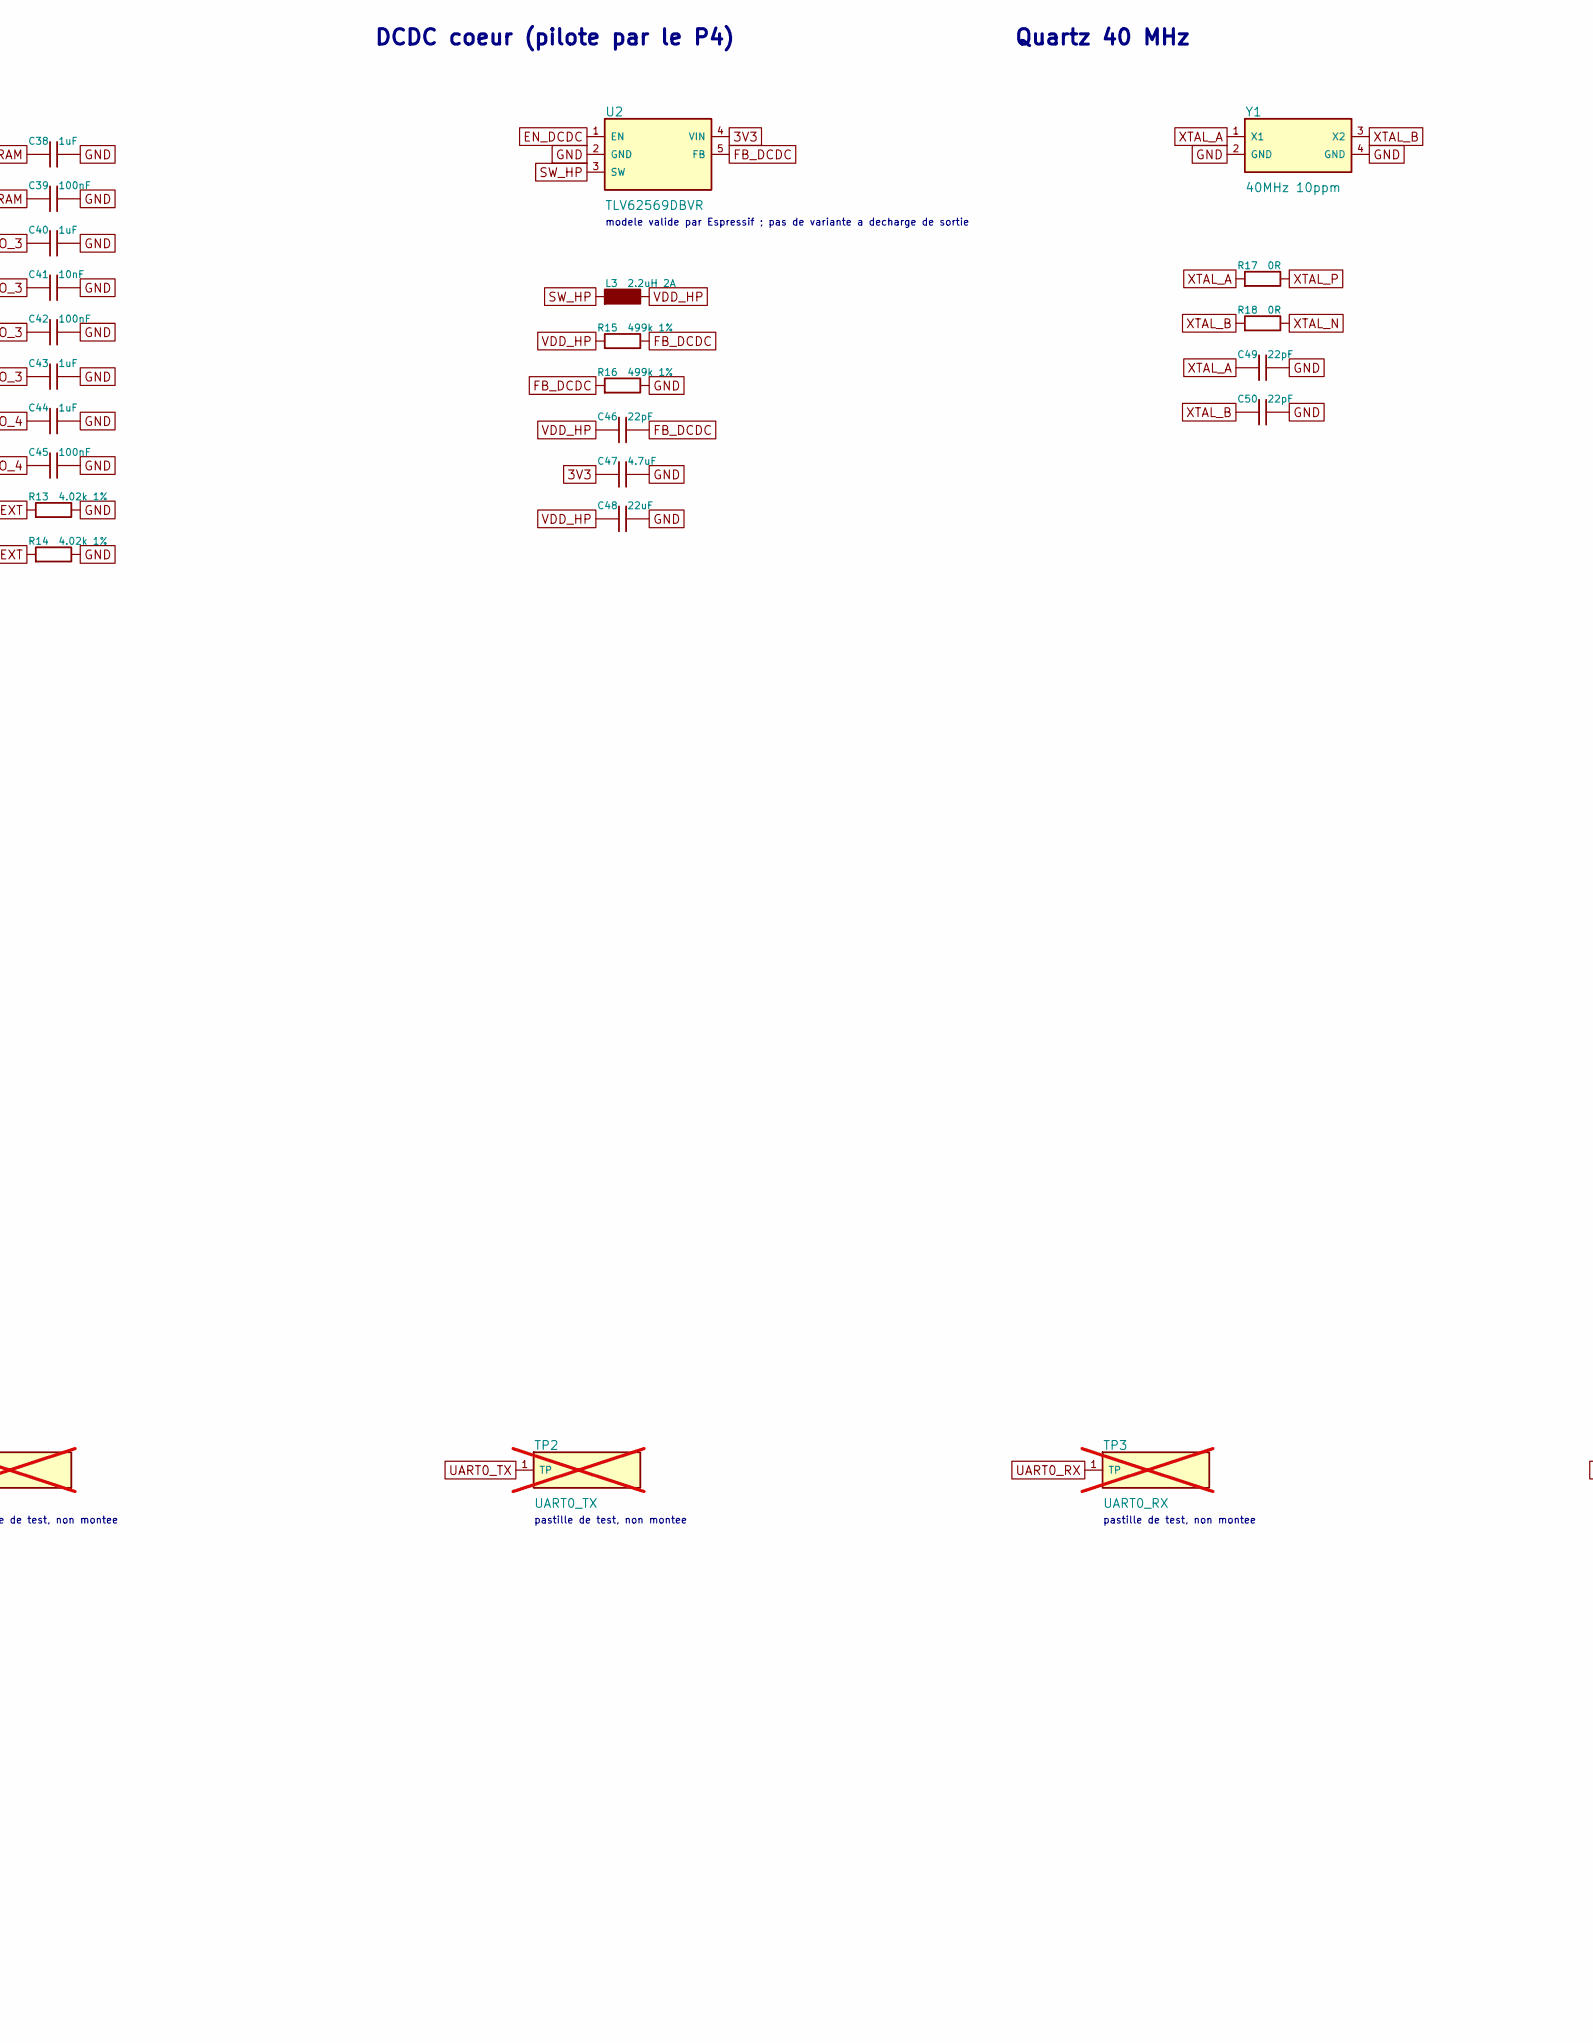
[picture p24: schematic mcu.kicad_sch, openKVM - ESP32-P4, part in row 1, column 2]

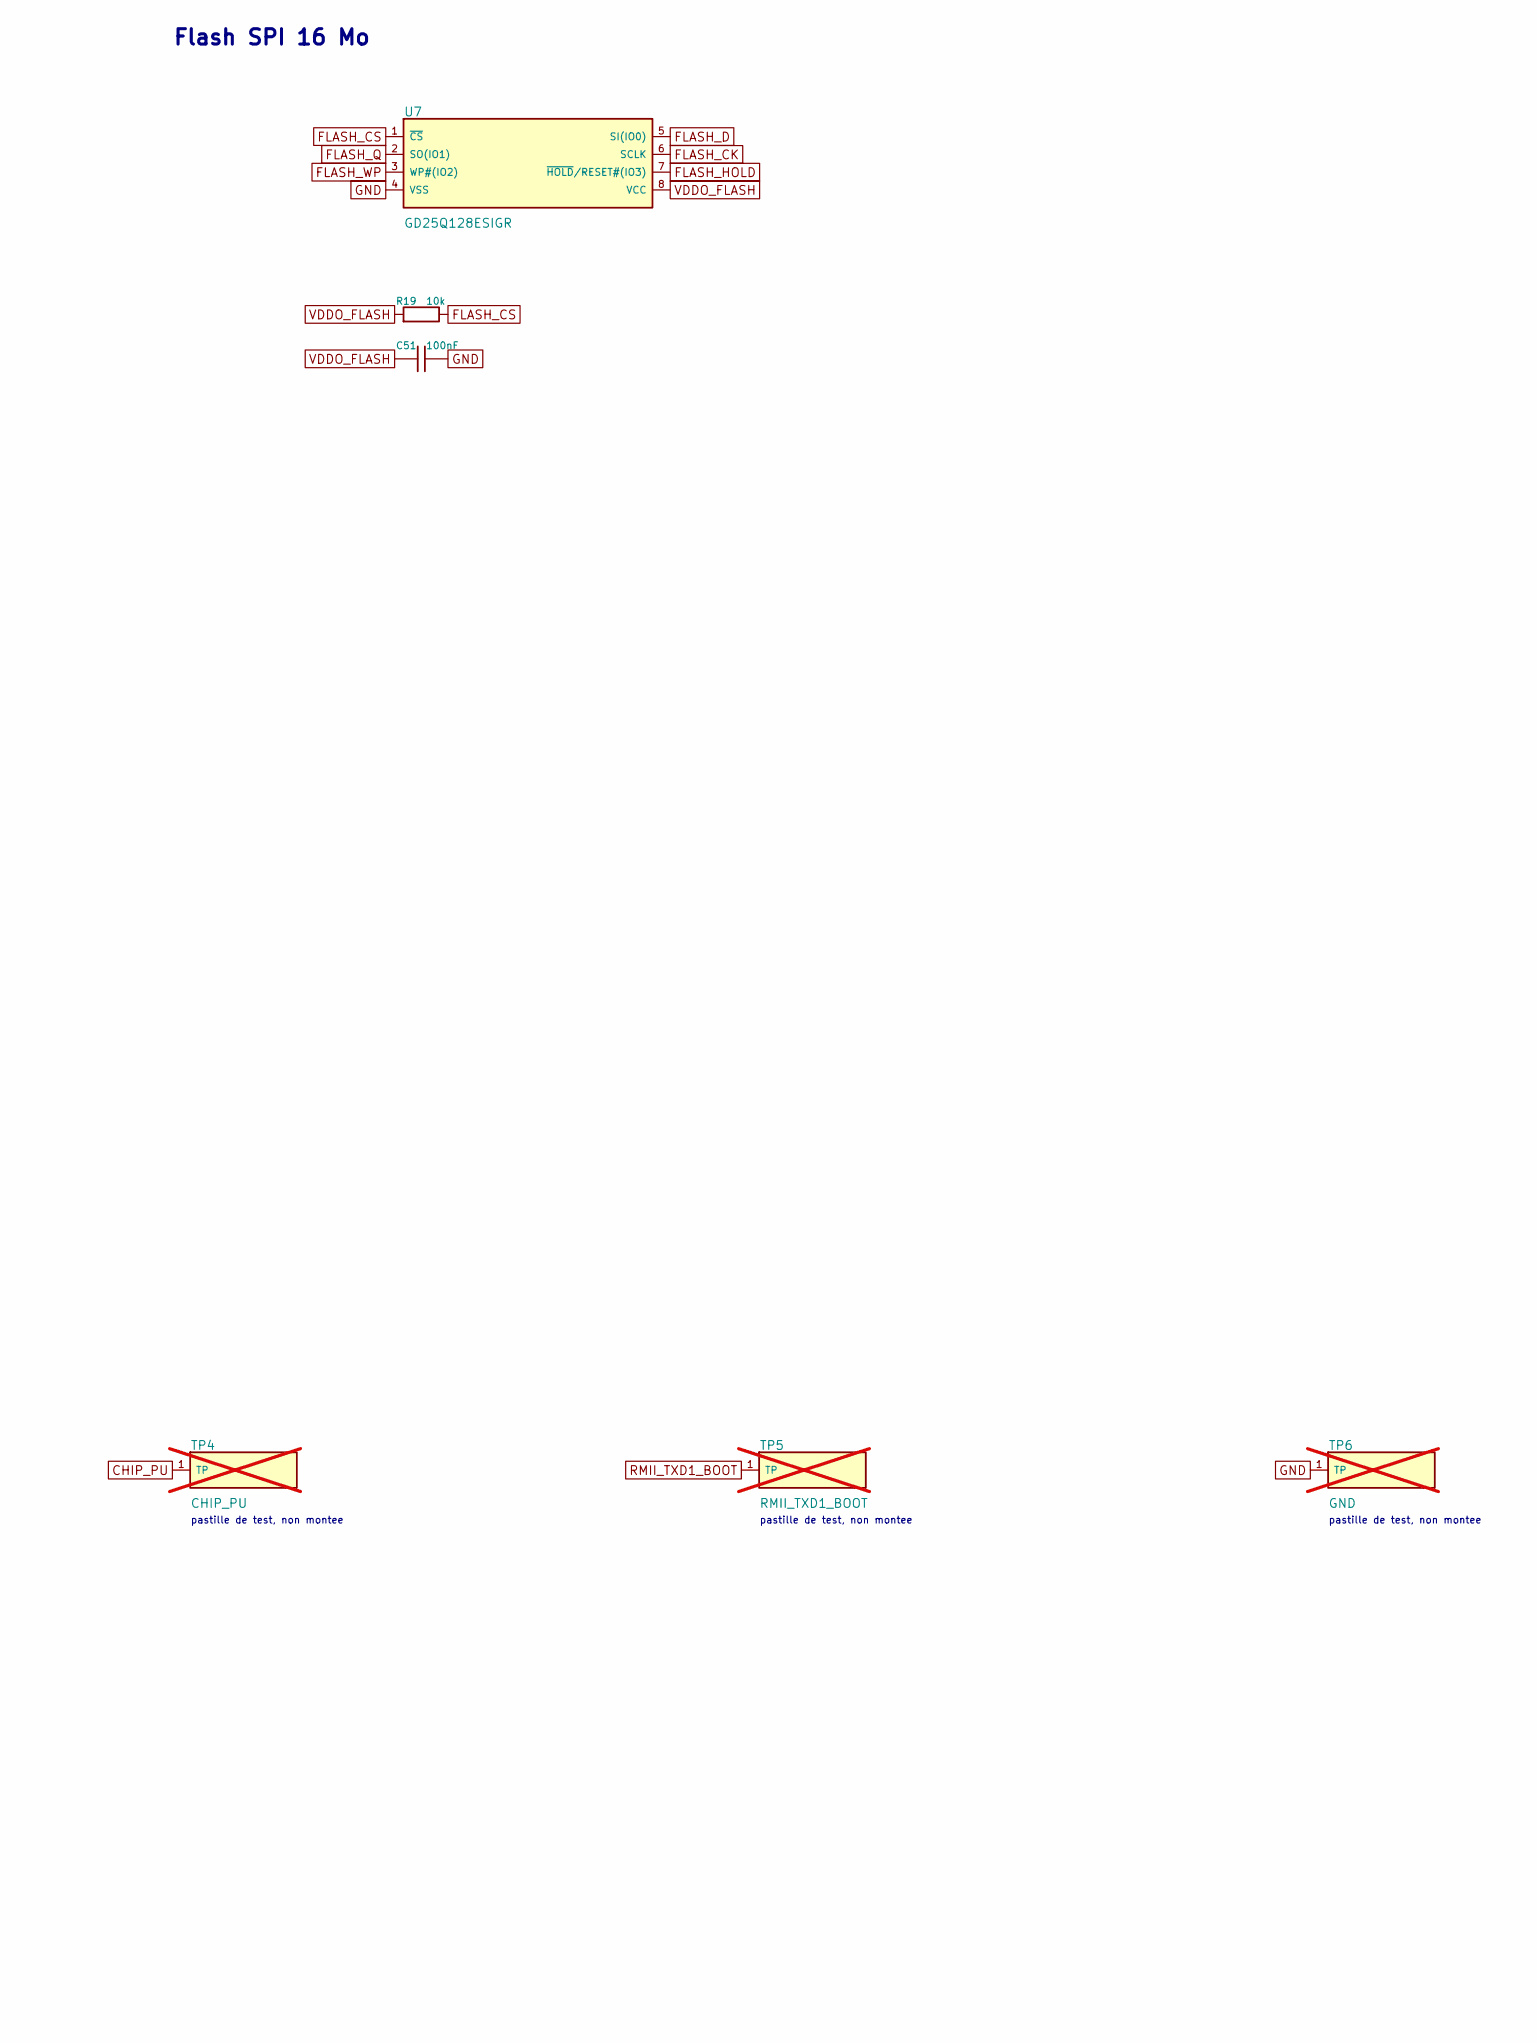
[picture p25: schematic mcu.kicad_sch, openKVM - ESP32-P4, part in row 1, column 3]

Parts:
C14, C20, C22, C27: 10uF; C_0603_1608Metric; MPN CL10A106KP8NNNC; LCSC C19702
C15, C16, C17, C18, C19, C21, C23, C25, C28, C29, C30, C31, C34, C37, C39, C42, C45, C51: 100nF; C_0402_1005Metric; MPN CL05B104KO5NNNC; LCSC C1525
C24, C41: 10nF; C_0402_1005Metric; MPN CL05B103KB5NNNC; LCSC C15195
C26, C47: 4.7uF; C_0603_1608Metric; MPN CL10A475KO8NNNC; LCSC C19666
C32, C33, C35, C36, C38, C40, C43, C44, C52: 1uF; C_0402_1005Metric; MPN CL05A105KA5NQNC; LCSC C52923
C46, C49, C50: 22pF; C_0402_1005Metric; MPN 0402CG220J500NT; LCSC C1555
C48: 22uF; C_0805_2012Metric; MPN CL21A226MAQNNNE; LCSC C45783
D3: LED jaune etat; LED0603-R-RD; MPN KT-0603Y; LCSC C2287
D4: LED verte alim; LED0603-RD; MPN KT-0603G; LCSC C12624
L3: 2.2uH 2A; IND-SMD_L3.0-W3.0; MPN SWPA3015S2R2MT; LCSC C43389
R11, R12, R17, R18: 0R; R_0402_1005Metric; MPN 0402WGF0000TCE; LCSC C17168
R13, R14: 4.02k 1%; R_0402_1005Metric; MPN 0402WGF4021TCE; LCSC C43251
R15, R16: 499k 1%; R_0402_1005Metric; MPN 0402WGF4993TCE; LCSC C25793
R19, R20, R21, R23: 10k; R_0402_1005Metric; MPN 0402WGF1002TCE; LCSC C25744
R22: 1k; R_0402_1005Metric; MPN 0402WGF1001TCE; LCSC C11702
R24: 470R; R_0402_1005Metric; MPN 0402WGF4700TCE; LCSC C25117
R25, R26: 4.7k; R_0402_1005Metric; MPN 0402WGF4701TCE; LCSC C25900
SW1: FN; KEY-SMD_TS-1101VS-C-A-A; MPN TS-1101VS-C-A-A; LCSC C318936
SW2: BOOT; SW-SMD_4P-L5.1-W5.1-P3.70-LS6.5-TL_H1.5; MPN TS-1187A-B-A-B; LCSC C318884
TP1: 3V3; TestPoint_Pad_D1.0mm; not fitted
TP2: UART0_TX; TestPoint_Pad_D1.0mm; not fitted
TP3: UART0_RX; TestPoint_Pad_D1.0mm; not fitted
TP4: CHIP_PU; TestPoint_Pad_D1.0mm; not fitted
TP5: RMII_TXD1_BOOT; TestPoint_Pad_D1.0mm; not fitted
TP6: GND; TestPoint_Pad_D1.0mm; not fitted
U1: ESP32-P4NRW32X; QFN-104_L10.0-W10.0-P0.35-TL-EP7.5; MPN ESP32-P4NRW32X; LCSC C54540373
U2: TLV62569DBVR; SOT-23-5_L3.0-W1.7-P0.95-LS2.8-BR; MPN TLV62569DBVR; LCSC C141836
U7: GD25Q128ESIGR; SOP-8_L5.3-W5.3-P1.27-LS8.0-BL; MPN GD25Q128ESIGR; LCSC C2928891
Y1: 40MHz 10ppm; OSC-SMD_4P-L3.2-W2.5-BL_SIT8008BI; MPN X322540MPB4SI; LCSC C9010

Connections:
3V3: C14.1, C15.1, C16.1, C17.1, C18.1, C19.1, C20.1, C21.1, C47.1, R11.1, R12.1, R20.1, R21.1, R23.1, R25.1, R26.1, TP1.1, U1.9 (VDD_LP), U1.21 (VDD_IO_0), U1.62 (VDD_IO_4), U1.75 (VDD_LDO), U1.77 (VDD_DCDCC), U1.96 (VDD_IO_6), U1.101 (VDD_ANA), U2.4 (VIN); also elsewhere on the board
5V_SYS: R22.1; also elsewhere on the board
BTN_FN: R23.2, SW1.3 (SW), U1.25 (GPIO23)
CHIP_PU: C52.1, R20.2, TP4.1, U1.103 (CHIP_PU)
CSI_CLK_N: U1.45 (CSI_CLKN); also elsewhere on the board
CSI_CLK_P: U1.44 (CSI_CLKP); also elsewhere on the board
CSI_D0_N: U1.42 (CSI_DATAN0); also elsewhere on the board
CSI_D0_P: U1.43 (CSI_DATAP0); also elsewhere on the board
CSI_D1_N: U1.46 (CSI_DATAN1); also elsewhere on the board
CSI_D1_P: U1.47 (CSI_DATAP1); also elsewhere on the board
CSI_REXT: R14.1, U1.48 (CSI_REXT)
DSI_REXT: R13.1, U1.34 (DSI_REXT)
EN_DCDC: U1.79 (EN_DCDC), U2.1 (EN)
FB_DCDC: C46.2, R15.2, R16.1, U1.78 (FB_DCDC), U2.5 (FB)
FLASH_CK: U1.32 (FLASH_CK), U7.6 (SCLK)
FLASH_CS: R19.2, U1.27 (FLASH_CS), U7.1 (~CS)
FLASH_D: U1.33 (FLASH_D), U7.5 (SI(IO0))
FLASH_HOLD: U1.31 (FLASH_HOLD), U7.7 (~HOLD/RESET#(IO3))
FLASH_Q: U1.28 (FLASH_Q), U7.2 (SO(IO1))
FLASH_WP: U1.29 (FLASH_WP), U7.3 (WP#(IO2))
GND: C14.2, C15.2, C16.2, C17.2, C18.2, C19.2, C20.2, C21.2, C22.2, C23.2, C24.2, C25.2, C26.2, C27.2, C28.2, C29.2, C30.2, C31.2, C32.2, C33.2, C34.2, C35.2, C36.2, C37.2, C38.2, C39.2, C40.2, C41.2, C42.2, C43.2, C44.2, C45.2, C47.2, C48.2, C49.2, C50.2, C51.2, C52.2, D3.2, D4.1, R13.2, R14.2, R16.2, SW1.1 (MNT), SW1.2 (MNT), SW1.4 (SW), SW2.3 (B), SW2.4 (B), TP6.1, U1.105 (GND), U2.2 (GND), U7.4 (VSS), Y1.2 (GND), Y1.4 (GND); also elsewhere on the board
I2C_SCL: R26.2, U1.5 (GPIO5); also elsewhere on the board
I2C_SDA: R25.2, U1.2 (GPIO2); also elsewhere on the board
LED_PWR_A: D4.2, R22.2
LED_STAT: R24.1, U1.6 (GPIO6)
LED_STAT_A: D3.1, R24.2
PHY_RST: U1.94 (GPIO51); also elsewhere on the board
RMII_CRS_DV: U1.57 (GPIO28); also elsewhere on the board
RMII_MDC: U1.61 (GPIO31); also elsewhere on the board
RMII_MDIO: U1.95 (GPIO52); also elsewhere on the board
RMII_REF_CLK: U1.93 (GPIO50); also elsewhere on the board
RMII_RXD0: U1.58 (GPIO29); also elsewhere on the board
RMII_RXD1: U1.60 (GPIO30); also elsewhere on the board
RMII_TXD0: U1.65 (GPIO34); also elsewhere on the board
RMII_TXD1_BOOT: R21.2, SW2.1 (A), SW2.2 (A), TP5.1, U1.66 (GPIO35); also elsewhere on the board
RMII_TX_EN: U1.92 (GPIO49); also elsewhere on the board
SD_CD: U1.7 (GPIO7); also elsewhere on the board
SD_CLK: U1.84 (GPIO43); also elsewhere on the board
SD_CMD: U1.86 (GPIO44); also elsewhere on the board
SD_D0: U1.80 (GPIO39); also elsewhere on the board
SD_D1: U1.81 (GPIO40); also elsewhere on the board
SD_D2: U1.82 (GPIO41); also elsewhere on the board
SD_D3: U1.83 (GPIO42); also elsewhere on the board
SD_PWR_EN_N: U1.8 (GPIO8); also elsewhere on the board
SW_HP: L3.1, U2.3 (SW)
TC_INT: U1.64 (GPIO33); also elsewhere on the board
TC_RESETN: U1.63 (GPIO32); also elsewhere on the board
UART0_RX: TP3.1, U1.70 (GPIO38)
UART0_TX: TP2.1, U1.69 (GPIO37)
USB_FS_DM: U1.52 (GPIO24); also elsewhere on the board
USB_FS_DP: U1.53 (GPIO25); also elsewhere on the board
USB_HS_DM: U1.49 (USB_DM); also elsewhere on the board
USB_HS_DP: U1.50 (USB_DP); also elsewhere on the board
VDDO_3: C40.1, C41.1, C42.1, C43.1, U1.41 (VDD_MIPI_DPHY), U1.73 (VDDO_3); also elsewhere on the board
VDDO_4: C44.1, C45.1, U1.74 (VDDO_4), U1.85 (VDD_IO_5); also elsewhere on the board
VDDO_FLASH: C32.1, C33.1, C34.1, C51.1, R19.1, U1.30 (VDD_FLASHIO), U1.71 (VDDO_FLASH), U7.8 (VCC)
VDDO_PSRAM: C35.1, C36.1, C37.1, C38.1, C39.1, U1.59 (VDD_PSRAM_0), U1.67 (VDD_PSRAM_1), U1.72 (VDDO_PSRAM)
VDD_BAT: C22.1, C23.1, R11.2, U1.102 (VDD_BAT)
VDD_HP: C27.1, C28.1, C29.1, C30.1, C31.1, C46.1, C48.1, L3.2, R15.1, U1.26 (VDD_HP_0), U1.54 (VDD_HP_1), U1.76 (VDD_HP_2), U1.91 (VDD_HP_3)
VDD_USBPHY: C24.1, C25.1, C26.1, R12.2, U1.51 (VDD_USBPHY)
XTAL_A: C49.1, R17.1, Y1.1 (X1)
XTAL_B: C50.1, R18.1, Y1.3 (X2)
XTAL_N: R18.2, U1.99 (XTAL_N)
XTAL_P: R17.2, U1.100 (XTAL_P)

Notes on the sheet:
ESP32-P4
revision de puce >= 3.x obligatoire
Decouplage P4 (au plus pres des broches)
DCDC coeur (pilote par le P4)
modele valide par Espressif ; pas de variante a decharge de sortie
Quartz 40 MHz
Flash SPI 16 Mo
Reset, boot, bouton, LED
GPIO23 : appui long = reinitialisation reseau / usine (firmware)
pastille de test, non montee
