gigi74168/openKVM/hardware/openkvm.kicad_pcb

## KiCad design hardware/openkvm.kicad_pcb (continued)

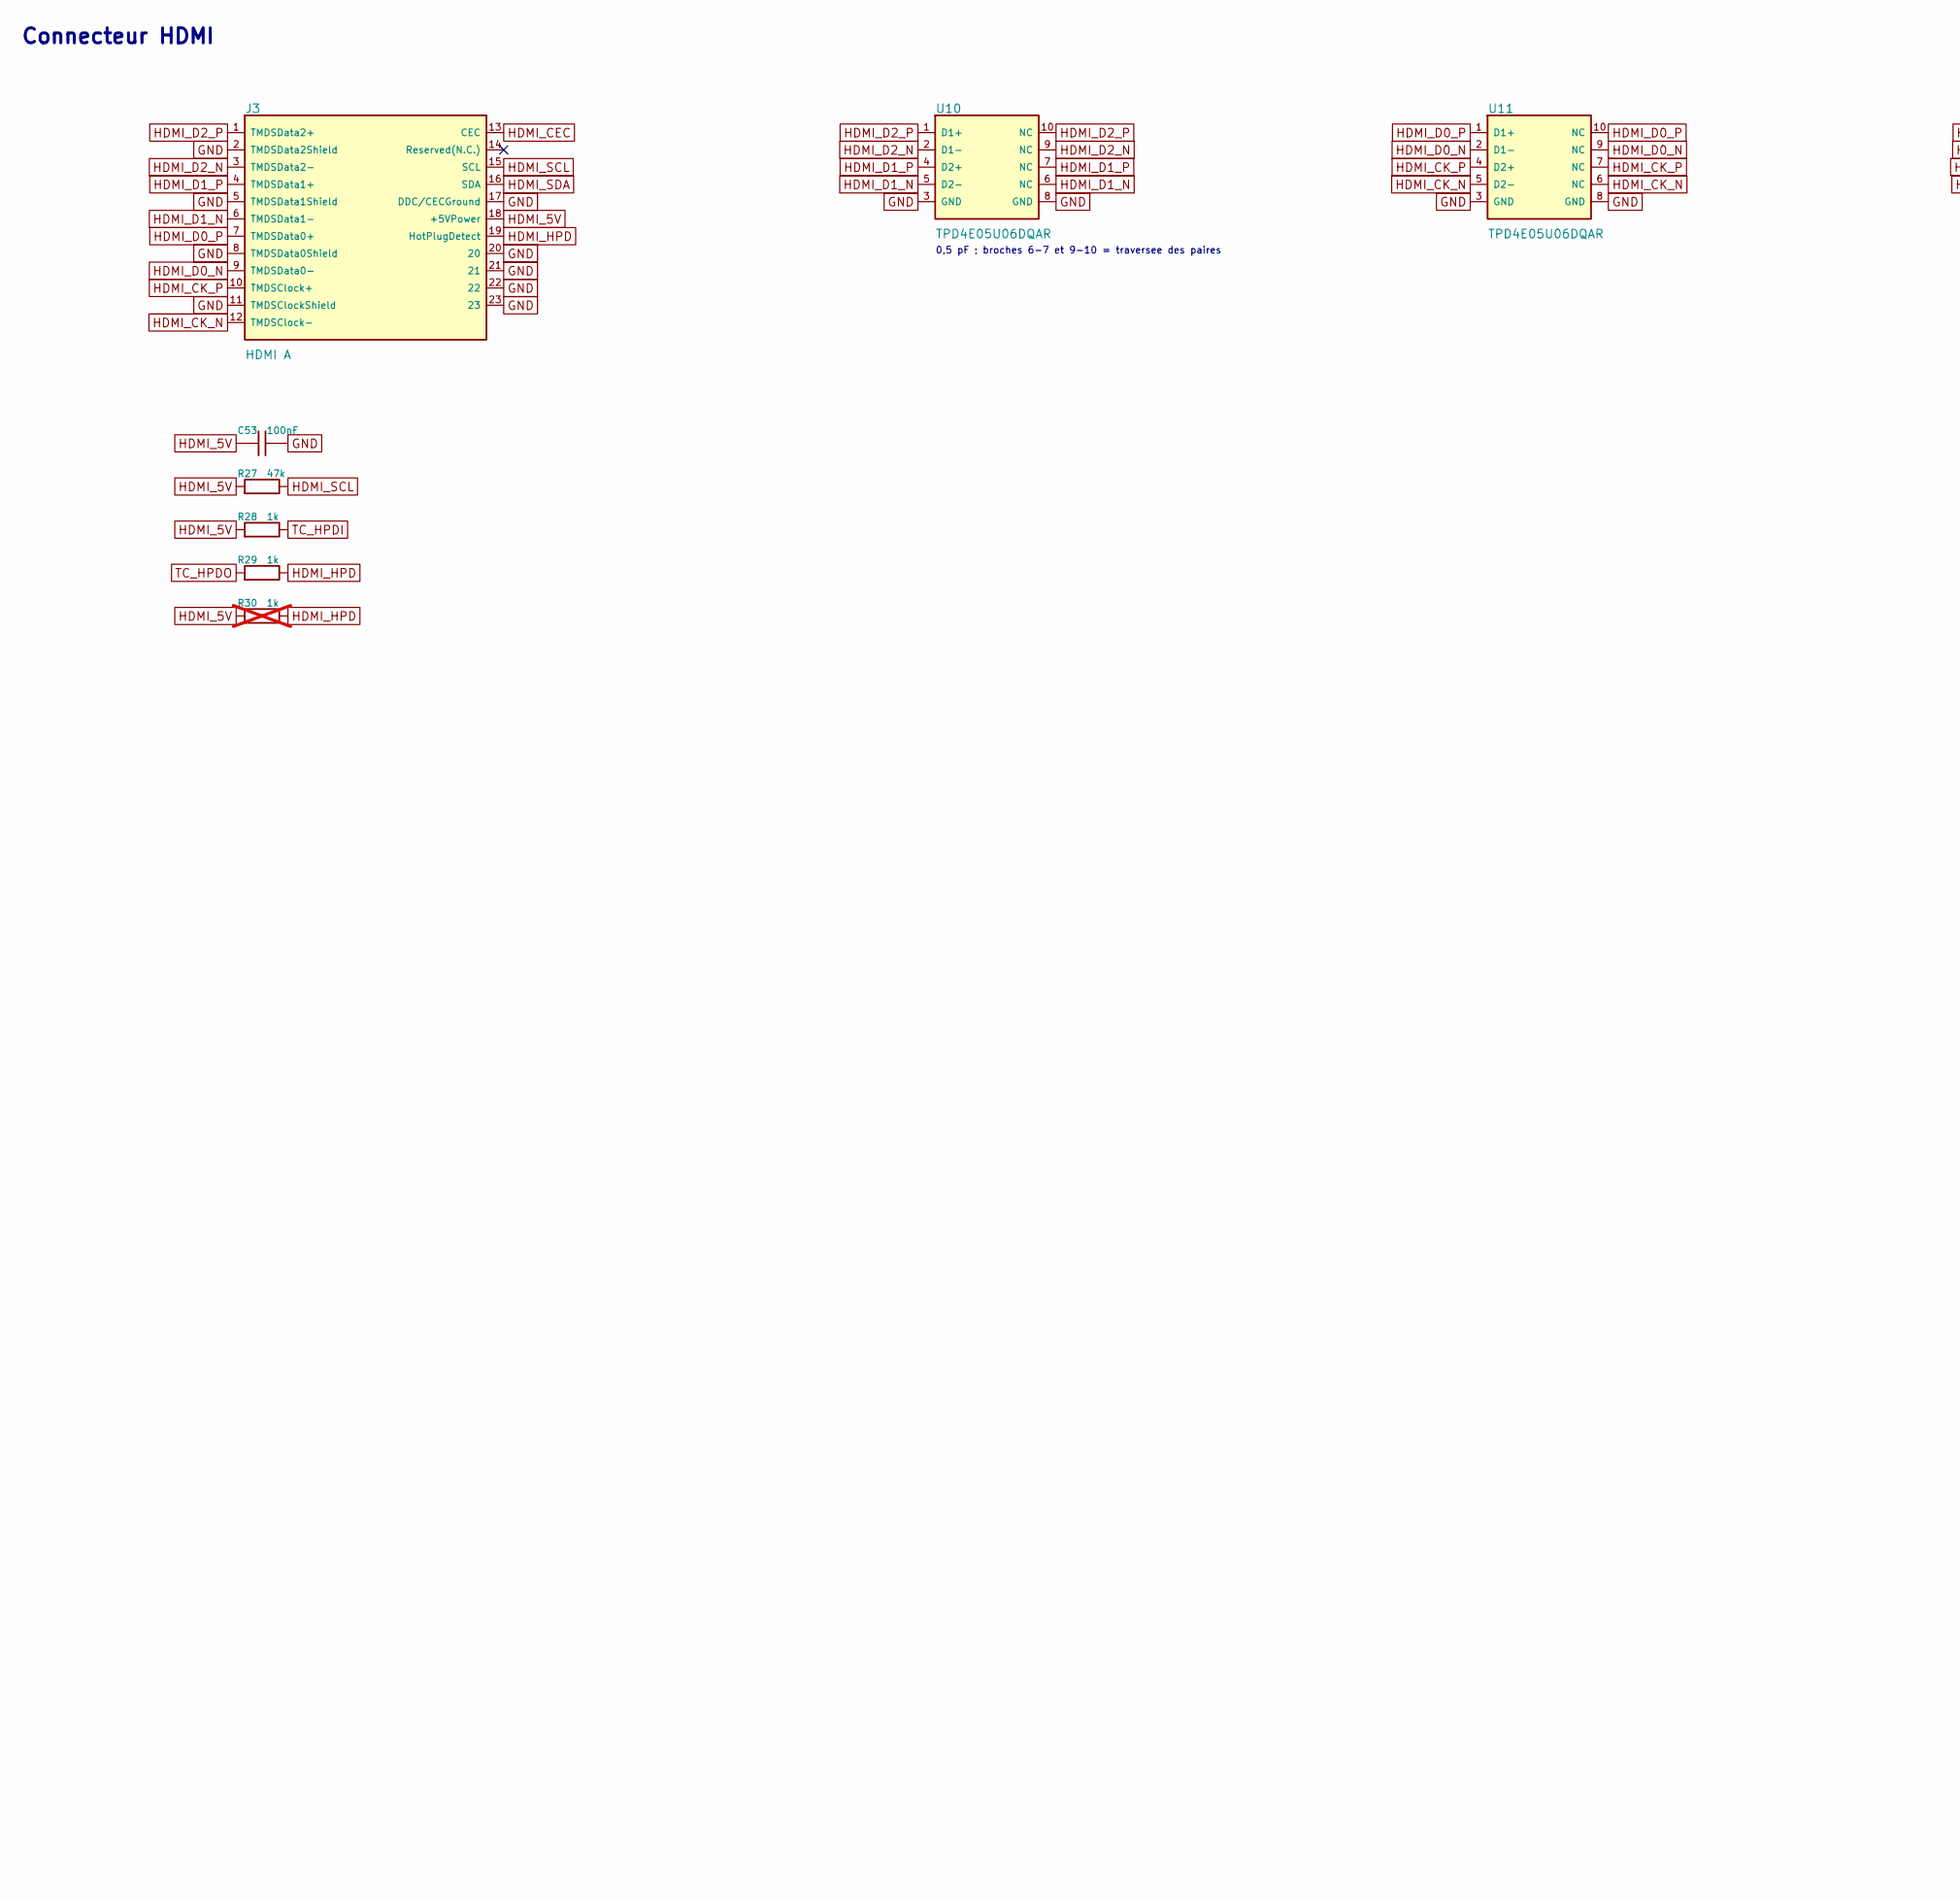
[picture p26: schematic hdmi.kicad_sch, openKVM - Capture HDMI, part in row 1, column 1]

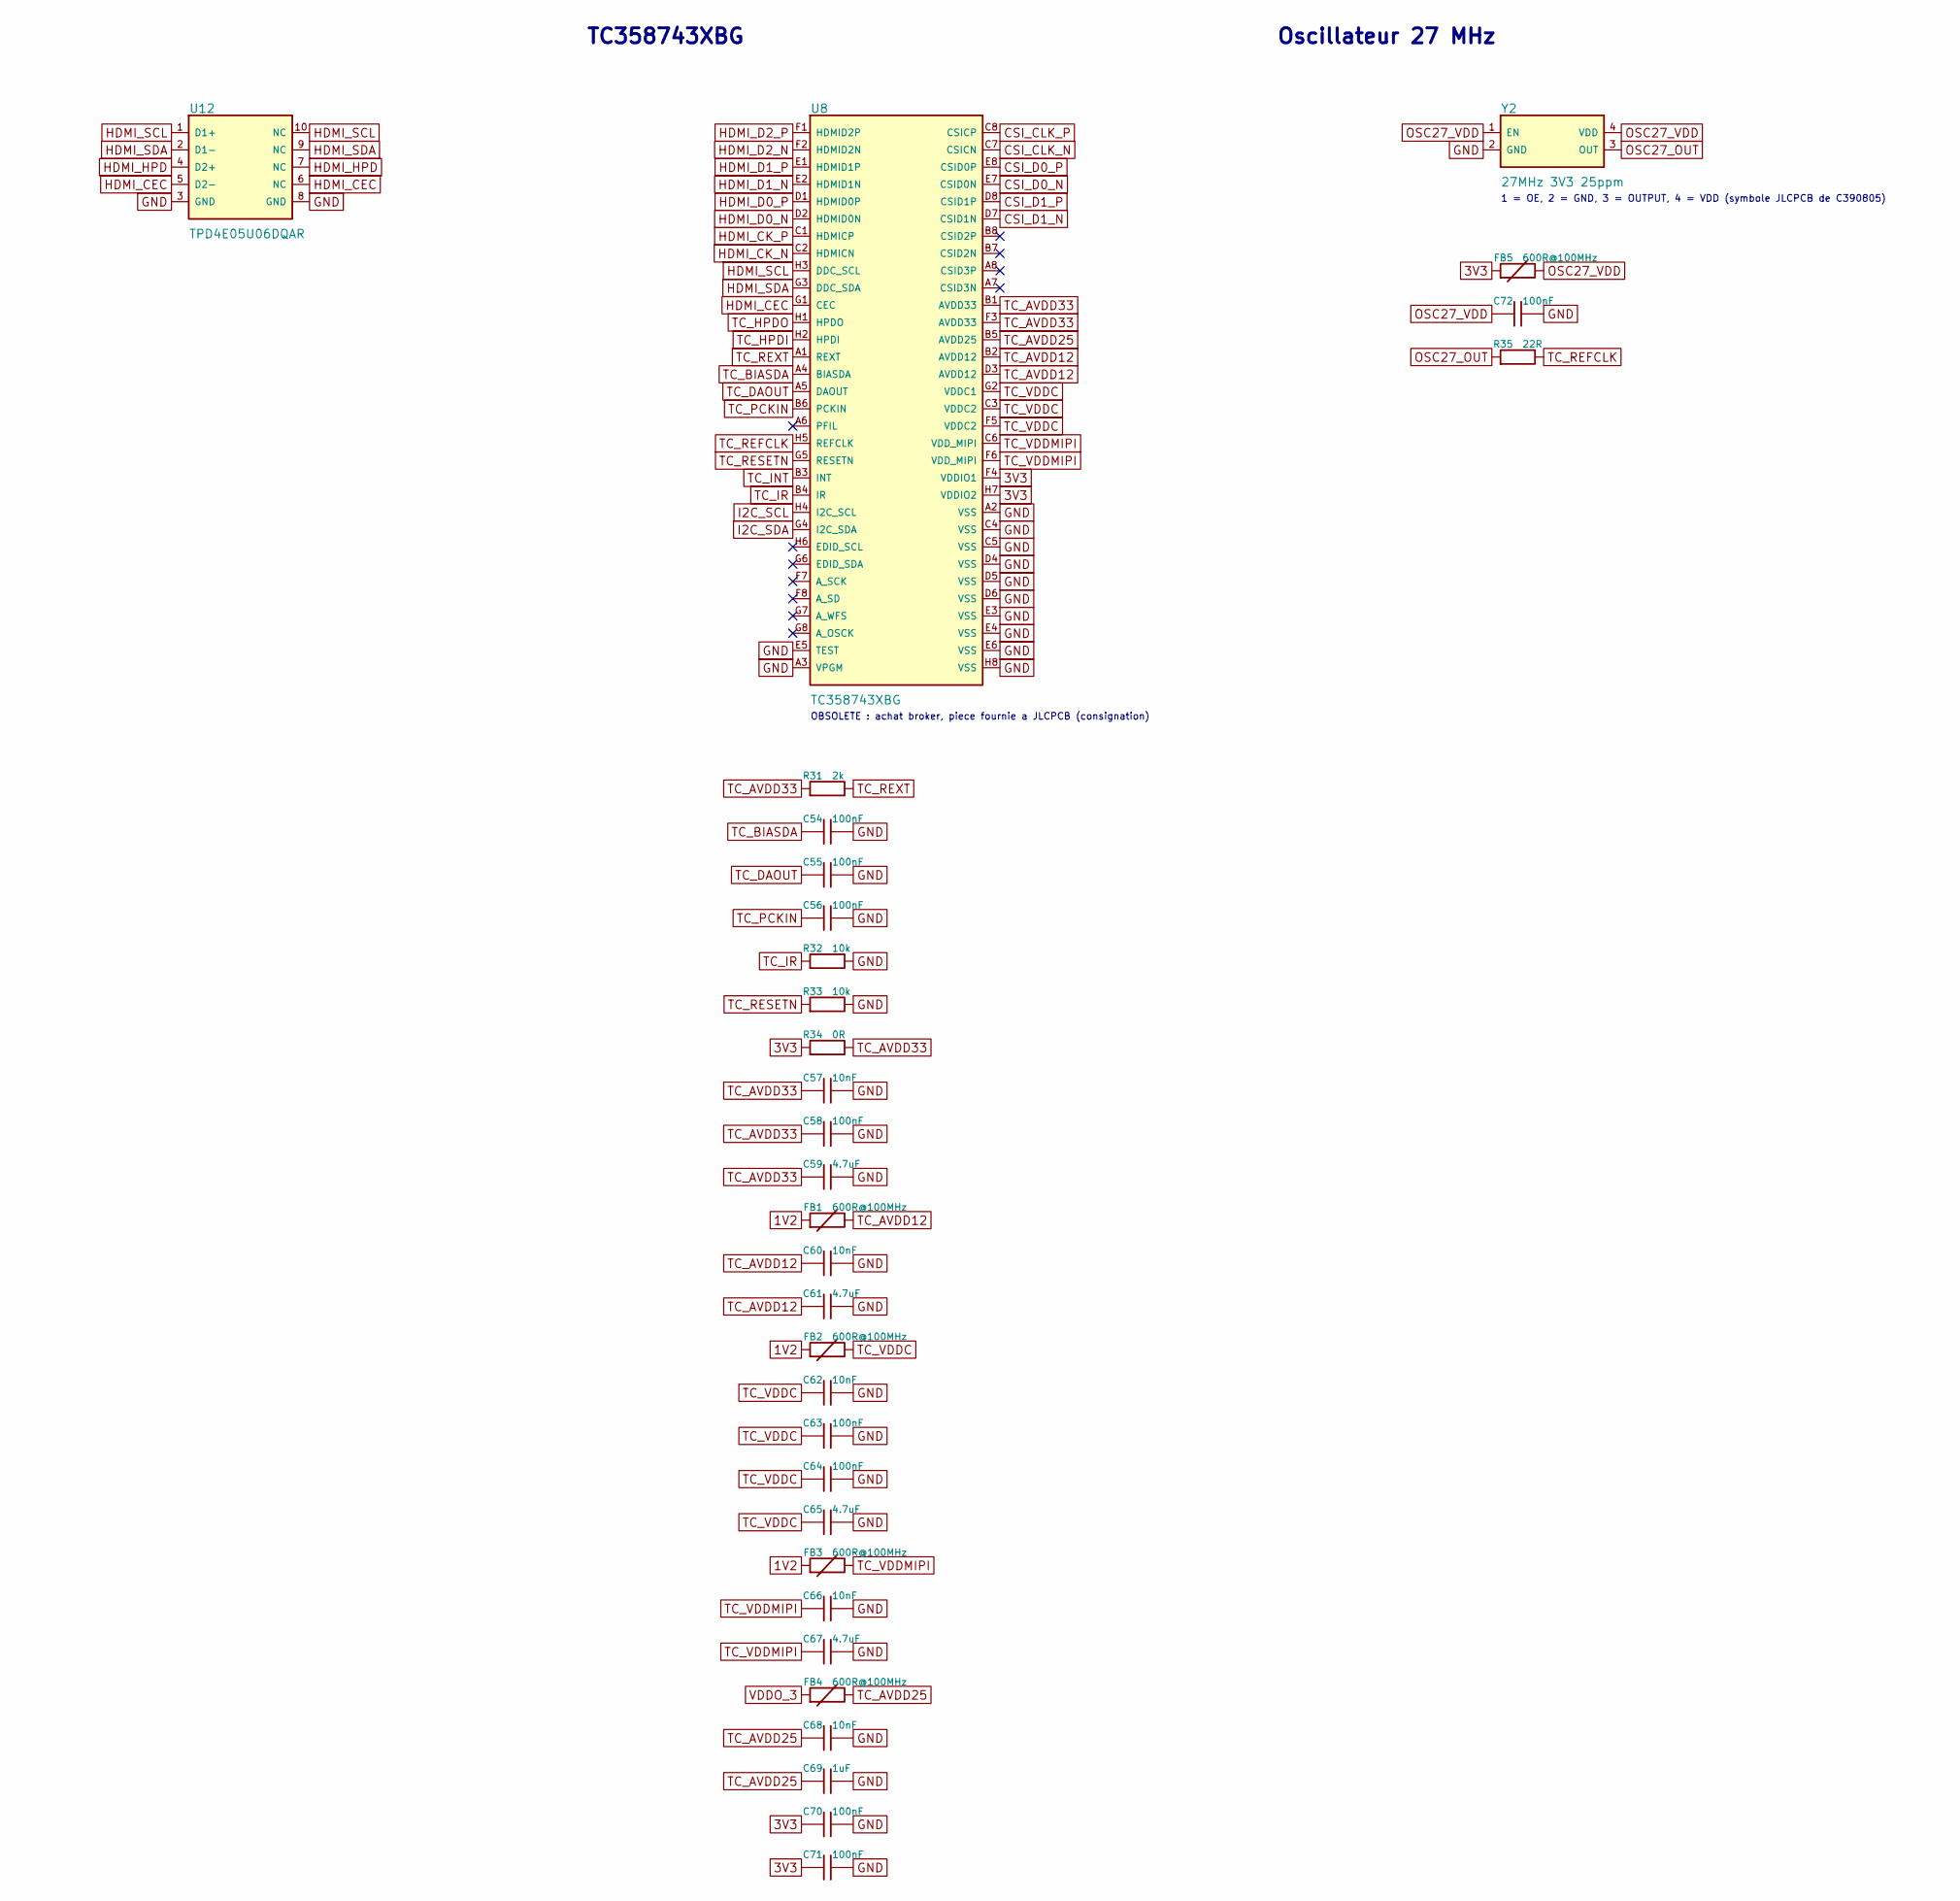
[picture p27: schematic hdmi.kicad_sch, openKVM - Capture HDMI, part in row 1, column 2]

Parts:
C53, C54, C55, C56, C58, C63, C64, C70, C71, C72: 100nF; C_0402_1005Metric; MPN CL05B104KO5NNNC; LCSC C1525
C57, C60, C62, C66, C68: 10nF; C_0402_1005Metric; MPN CL05B103KB5NNNC; LCSC C15195
C59, C61, C65, C67: 4.7uF; C_0603_1608Metric; MPN CL10A475KO8NNNC; LCSC C19666
C69: 1uF; C_0402_1005Metric; MPN CL05A105KA5NQNC; LCSC C52923
FB1, FB2, FB3, FB4, FB5: 600R@100MHz; L_0603_1608Metric; MPN BLM18KG601SN1D; LCSC C85833
J3: HDMI A; HDMI-SMD_19P-P0.50-H-F; MPN HDMI-001 19PCBTP; LCSC C138388
R27: 47k; R_0402_1005Metric; MPN 0402WGF4702TCE; LCSC C25792
R28, R29: 1k; R_0402_1005Metric; MPN 0402WGF1001TCE; LCSC C11702
R30: 1k; R_0402_1005Metric; MPN 0402WGF1001TCE; LCSC C11702; not fitted
R31: 2k; R_0402_1005Metric; MPN 0402WGF2001TCE; LCSC C4109
R32, R33: 10k; R_0402_1005Metric; MPN 0402WGF1002TCE; LCSC C25744
R34: 0R; R_0402_1005Metric; MPN 0402WGF0000TCE; LCSC C17168
R35: 22R; R_0402_1005Metric; MPN 0402WGF220JTCE; LCSC C25092
U8: TC358743XBG; BGA-64_8x8_6.0x6.0mm; MPN TC358743XBG
U10, U11, U12: TPD4E05U06DQAR; USON-10_L2.5-W1.0-P0.50-BL; MPN TPD4E05U06DQAR; LCSC C138714
Y2: 27MHz 3V3 25ppm; OSC-SMD_4P-L3.2-W2.5-BL; MPN O3227000153350; LCSC C390805

Connections:
1V2: FB1.1, FB2.1, FB3.1; also elsewhere on the board
3V3: C70.1, C71.1, FB5.1, R34.1, U8.F4 (VDDIO1), U8.H7 (VDDIO2); also elsewhere on the board
CSI_CLK_N: U8.C7 (CSICN); also elsewhere on the board
CSI_CLK_P: U8.C8 (CSICP); also elsewhere on the board
CSI_D0_N: U8.E7 (CSID0N); also elsewhere on the board
CSI_D0_P: U8.E8 (CSID0P); also elsewhere on the board
CSI_D1_N: U8.D7 (CSID1N); also elsewhere on the board
CSI_D1_P: U8.D8 (CSID1P); also elsewhere on the board
GND: C53.2, C54.2, C55.2, C56.2, C57.2, C58.2, C59.2, C60.2, C61.2, C62.2, C63.2, C64.2, C65.2, C66.2, C67.2, C68.2, C69.2, C70.2, C71.2, C72.2, J3.2 (TMDSData2Shield), J3.5 (TMDSData1Shield), J3.8 (TMDSData0Shield), J3.11 (TMDSClockShield), J3.17 (DDC/CECGround), J3.20, J3.21, J3.22, J3.23, R32.2, R33.2, U8.A2 (VSS), U8.A3 (VPGM), U8.C4 (VSS), U8.C5 (VSS), U8.D4 (VSS), U8.D5 (VSS), U8.D6 (VSS), U8.E3 (VSS), U8.E4 (VSS), U8.E5 (TEST), U8.E6 (VSS), U8.H8 (VSS), U10.3 (GND), U10.8 (GND), U11.3 (GND), U11.8 (GND), U12.3 (GND), U12.8 (GND), Y2.2 (GND); also elsewhere on the board
HDMI_5V: C53.1, J3.18 (+5VPower), R27.1, R28.1, R30.1
HDMI_CEC: J3.13 (CEC), U8.G1 (CEC), U12.5 (D2-), U12.6 (NC)
HDMI_CK_N: J3.12 (TMDSClock-), U8.C2 (HDMICN), U11.5 (D2-), U11.6 (NC)
HDMI_CK_P: J3.10 (TMDSClock+), U8.C1 (HDMICP), U11.4 (D2+), U11.7 (NC)
HDMI_D0_N: J3.9 (TMDSData0-), U8.D2 (HDMID0N), U11.2 (D1-), U11.9 (NC)
HDMI_D0_P: J3.7 (TMDSData0+), U8.D1 (HDMID0P), U11.1 (D1+), U11.10 (NC)
HDMI_D1_N: J3.6 (TMDSData1-), U8.E2 (HDMID1N), U10.5 (D2-), U10.6 (NC)
HDMI_D1_P: J3.4 (TMDSData1+), U8.E1 (HDMID1P), U10.4 (D2+), U10.7 (NC)
HDMI_D2_N: J3.3 (TMDSData2-), U8.F2 (HDMID2N), U10.2 (D1-), U10.9 (NC)
HDMI_D2_P: J3.1 (TMDSData2+), U8.F1 (HDMID2P), U10.1 (D1+), U10.10 (NC)
HDMI_HPD: J3.19 (HotPlugDetect), R29.2, R30.2, U12.4 (D2+), U12.7 (NC)
HDMI_SCL: J3.15 (SCL), R27.2, U8.H3 (DDC_SCL), U12.1 (D1+), U12.10 (NC)
HDMI_SDA: J3.16 (SDA), U8.G3 (DDC_SDA), U12.2 (D1-), U12.9 (NC)
I2C_SCL: U8.H4 (I2C_SCL); also elsewhere on the board
I2C_SDA: U8.G4 (I2C_SDA); also elsewhere on the board
OSC27_OUT: R35.1, Y2.3 (OUT)
OSC27_VDD: C72.1, FB5.2, Y2.1 (EN), Y2.4 (VDD)
TC_AVDD12: C60.1, C61.1, FB1.2, U8.B2 (AVDD12), U8.D3 (AVDD12)
TC_AVDD25: C68.1, C69.1, FB4.2, U8.B5 (AVDD25)
TC_AVDD33: C57.1, C58.1, C59.1, R31.1, R34.2, U8.B1 (AVDD33), U8.F3 (AVDD33)
TC_BIASDA: C54.1, U8.A4 (BIASDA)
TC_DAOUT: C55.1, U8.A5 (DAOUT)
TC_HPDI: R28.2, U8.H2 (HPDI)
TC_HPDO: R29.1, U8.H1 (HPDO)
TC_INT: U8.B3 (INT); also elsewhere on the board
TC_IR: R32.1, U8.B4 (IR)
TC_PCKIN: C56.1, U8.B6 (PCKIN)
TC_REFCLK: R35.2, U8.H5 (REFCLK)
TC_RESETN: R33.1, U8.G5 (RESETN); also elsewhere on the board
TC_REXT: R31.2, U8.A1 (REXT)
TC_VDDC: C62.1, C63.1, C64.1, C65.1, FB2.2, U8.C3 (VDDC2), U8.F5 (VDDC2), U8.G2 (VDDC1)
TC_VDDMIPI: C66.1, C67.1, FB3.2, U8.C6 (VDD_MIPI), U8.F6 (VDD_MIPI)
VDDO_3: FB4.1; also elsewhere on the board

Notes on the sheet:
Connecteur HDMI
0,5 pF ; broches 6-7 et 9-10 = traversee des paires
TC358743XBG
OBSOLETE : achat broker, piece fournie a JLCPCB (consignation)
Oscillateur 27 MHz
1 = OE, 2 = GND, 3 = OUTPUT, 4 = VDD (symbole JLCPCB de C390805)

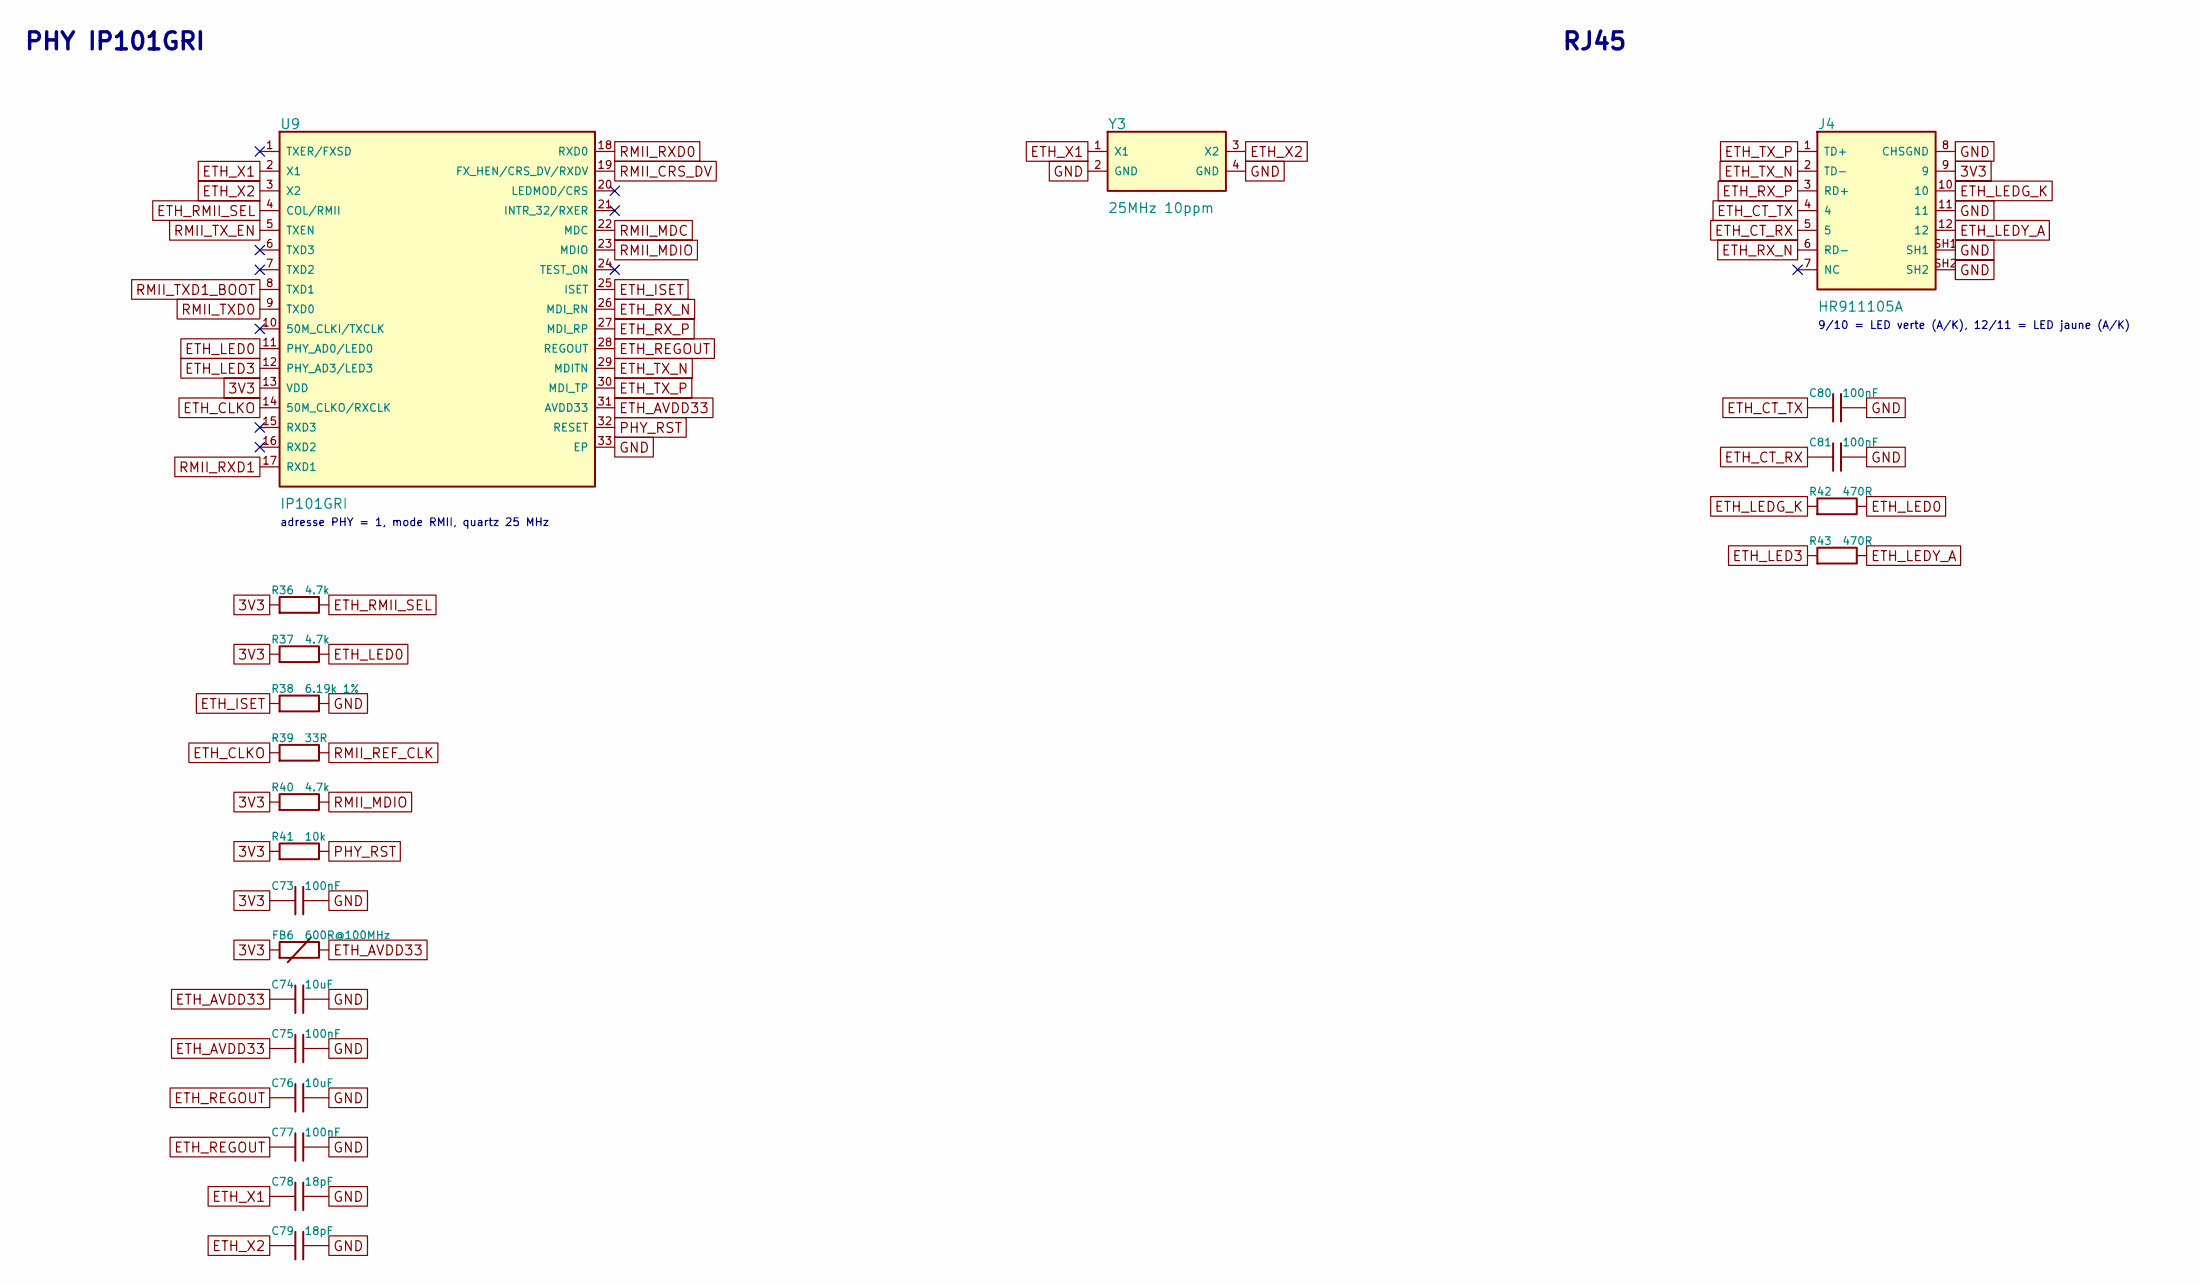
[picture p28: schematic eth.kicad_sch, openKVM - Ethernet]

Parts:
C73, C75, C77, C80, C81: 100nF; C_0402_1005Metric; MPN CL05B104KO5NNNC; LCSC C1525
C74, C76: 10uF; C_0603_1608Metric; MPN CL10A106KP8NNNC; LCSC C19702
C78, C79: 18pF; C_0402_1005Metric; MPN 0402CG180J500NT; LCSC C1549
FB6: 600R@100MHz; L_0603_1608Metric; MPN BLM18KG601SN1D; LCSC C85833
J4: HR911105A; RJ45-TH_HR911105A; MPN HR911105A; LCSC C12074
R36, R37, R40: 4.7k; R_0402_1005Metric; MPN 0402WGF4701TCE; LCSC C25900
R38: 6.19k 1%; R_0402_1005Metric; MPN 0402WGF6191TCE; LCSC C25914
R39: 33R; R_0402_1005Metric; MPN 0402WGF330JTCE; LCSC C25105
R41: 10k; R_0402_1005Metric; MPN 0402WGF1002TCE; LCSC C25744
R42, R43: 470R; R_0402_1005Metric; MPN 0402WGF4700TCE; LCSC C25117
U9: IP101GRI; QFN-32_L4.0-W4.0-P0.40-BL-EP2.7; MPN IP101GRI; LCSC C703537
Y3: 25MHz 10ppm; CRYSTAL-SMD_4P-L3.2-W2.5-BL; MPN X322525MOB4SI; LCSC C9006

Connections:
3V3: C73.1, FB6.1, J4.9, R36.1, R37.1, R40.1, R41.1, U9.13 (VDD); also elsewhere on the board
ETH_AVDD33: C74.1, C75.1, FB6.2, U9.31 (AVDD33)
ETH_CLKO: R39.1, U9.14 (50M_CLKO/RXCLK)
ETH_CT_RX: C81.1, J4.5
ETH_CT_TX: C80.1, J4.4
ETH_ISET: R38.1, U9.25 (ISET)
ETH_LED0: R37.2, R42.2, U9.11 (PHY_AD0/LED0)
ETH_LED3: R43.1, U9.12 (PHY_AD3/LED3)
ETH_LEDG_K: J4.10, R42.1
ETH_LEDY_A: J4.12, R43.2
ETH_REGOUT: C76.1, C77.1, U9.28 (REGOUT)
ETH_RMII_SEL: R36.2, U9.4 (COL/RMII)
ETH_RX_N: J4.6 (RD-), U9.26 (MDI_RN)
ETH_RX_P: J4.3 (RD+), U9.27 (MDI_RP)
ETH_TX_N: J4.2 (TD-), U9.29 (MDITN)
ETH_TX_P: J4.1 (TD+), U9.30 (MDI_TP)
ETH_X1: C78.1, U9.2 (X1), Y3.1 (X1)
ETH_X2: C79.1, U9.3 (X2), Y3.3 (X2)
GND: C73.2, C74.2, C75.2, C76.2, C77.2, C78.2, C79.2, C80.2, C81.2, J4.8 (CHSGND), J4.11, J4.SH1, J4.SH2, R38.2, U9.33 (EP), Y3.2 (GND), Y3.4 (GND); also elsewhere on the board
PHY_RST: R41.2, U9.32 (RESET); also elsewhere on the board
RMII_CRS_DV: U9.19 (FX_HEN/CRS_DV/RXDV); also elsewhere on the board
RMII_MDC: U9.22 (MDC); also elsewhere on the board
RMII_MDIO: R40.2, U9.23 (MDIO); also elsewhere on the board
RMII_REF_CLK: R39.2; also elsewhere on the board
RMII_RXD0: U9.18 (RXD0); also elsewhere on the board
RMII_RXD1: U9.17 (RXD1); also elsewhere on the board
RMII_TXD0: U9.9 (TXD0); also elsewhere on the board
RMII_TXD1_BOOT: U9.8 (TXD1); also elsewhere on the board
RMII_TX_EN: U9.5 (TXEN); also elsewhere on the board

Notes on the sheet:
PHY IP101GRI
adresse PHY = 1, mode RMII, quartz 25 MHz
RJ45
9/10 = LED verte (A/K), 12/11 = LED jaune (A/K)

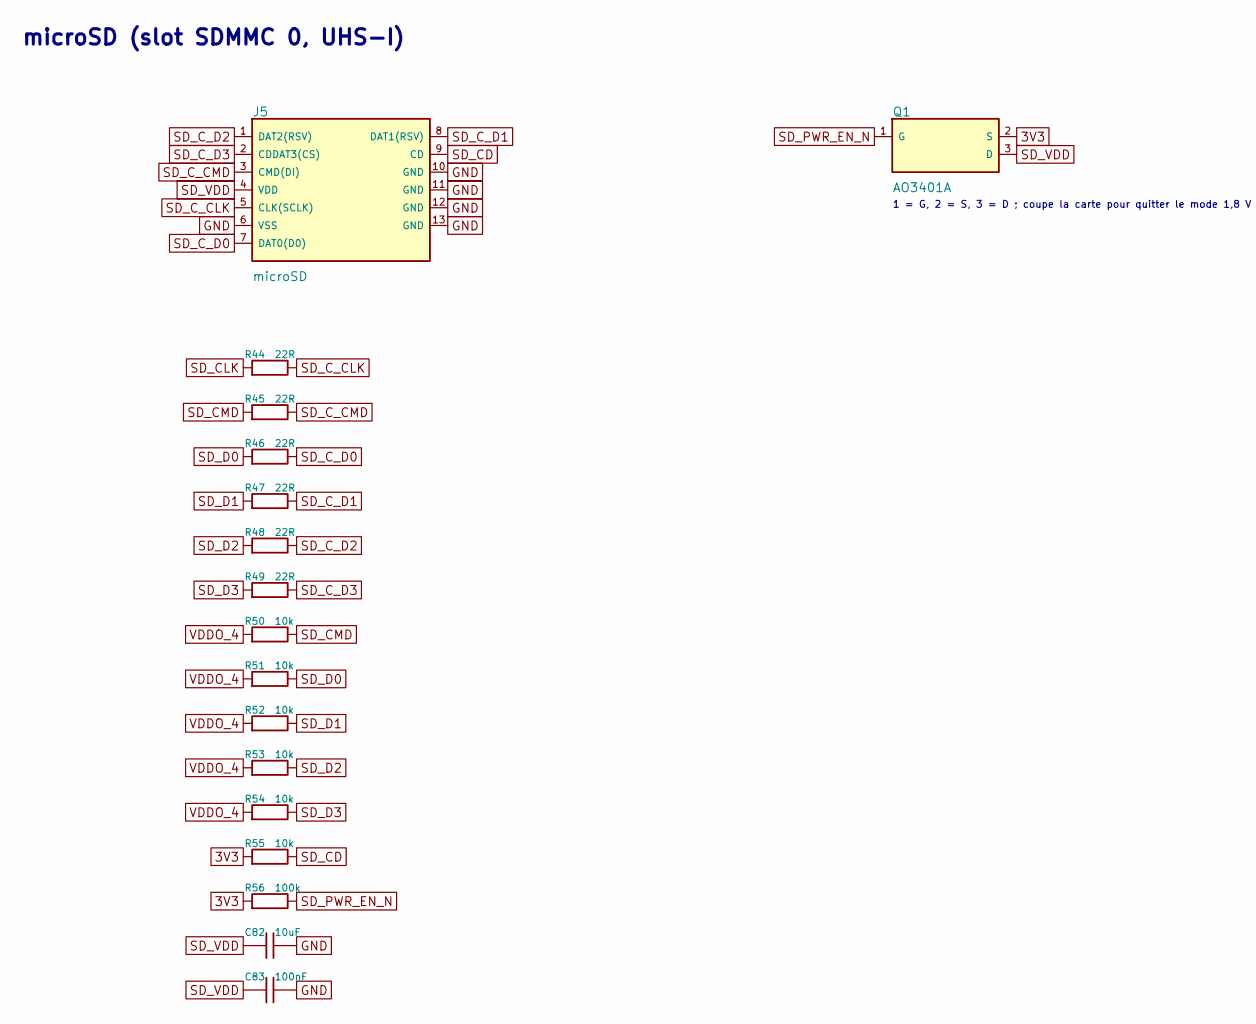
[picture p29: schematic periph.kicad_sch, openKVM - Peripheriques, part in row 1, column 1]

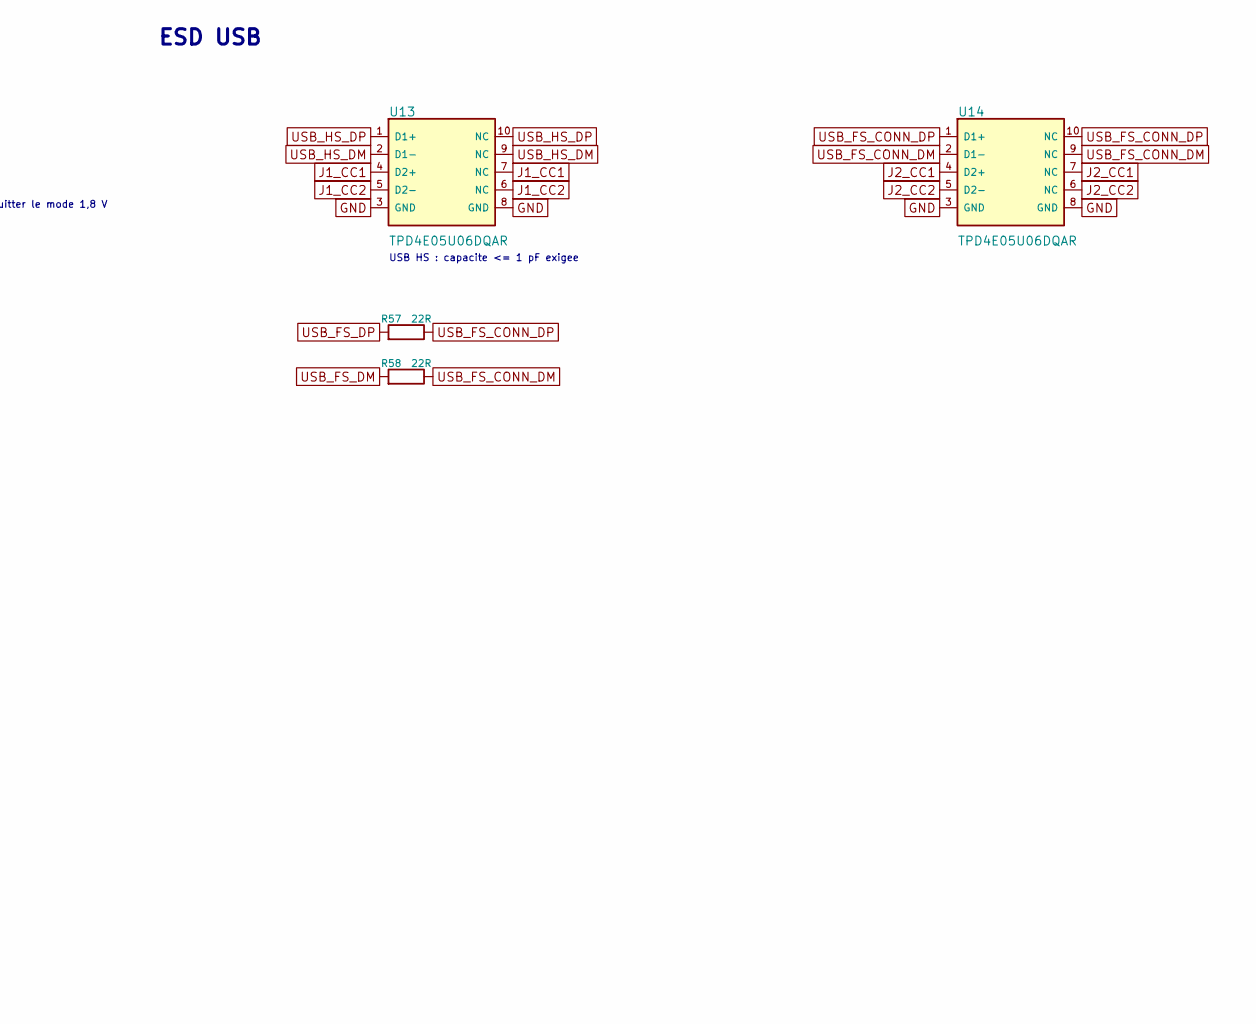
[picture p30: schematic periph.kicad_sch, openKVM - Peripheriques, part in row 1, column 2]

Parts:
C82: 10uF; C_0603_1608Metric; MPN CL10A106KP8NNNC; LCSC C19702
C83: 100nF; C_0402_1005Metric; MPN CL05B104KO5NNNC; LCSC C1525
J5: microSD; TF-SMD_TF-01A; MPN TF-01A; LCSC C91145
Q1: AO3401A; SOT-23_L2.9-W1.3-P1.90-LS2.4-BR; MPN AO3401A; LCSC C15127
R44, R45, R46, R47, R48, R49, R57, R58: 22R; R_0402_1005Metric; MPN 0402WGF220JTCE; LCSC C25092
R50, R51, R52, R53, R54, R55: 10k; R_0402_1005Metric; MPN 0402WGF1002TCE; LCSC C25744
R56: 100k; R_0402_1005Metric; MPN 0402WGF1003TCE; LCSC C25741
U13, U14: TPD4E05U06DQAR; USON-10_L2.5-W1.0-P0.50-BL; MPN TPD4E05U06DQAR; LCSC C138714

Connections:
3V3: Q1.2 (S), R55.1, R56.1; also elsewhere on the board
GND: C82.2, C83.2, J5.6 (VSS), J5.10 (GND), J5.11 (GND), J5.12 (GND), J5.13 (GND), U13.3 (GND), U13.8 (GND), U14.3 (GND), U14.8 (GND); also elsewhere on the board
J1_CC1: U13.4 (D2+), U13.7 (NC); also elsewhere on the board
J1_CC2: U13.5 (D2-), U13.6 (NC); also elsewhere on the board
J2_CC1: U14.4 (D2+), U14.7 (NC); also elsewhere on the board
J2_CC2: U14.5 (D2-), U14.6 (NC); also elsewhere on the board
SD_CD: J5.9 (CD), R55.2; also elsewhere on the board
SD_CLK: R44.1; also elsewhere on the board
SD_CMD: R45.1, R50.2; also elsewhere on the board
SD_C_CLK: J5.5 (CLK(SCLK)), R44.2
SD_C_CMD: J5.3 (CMD(DI)), R45.2
SD_C_D0: J5.7 (DAT0(D0)), R46.2
SD_C_D1: J5.8 (DAT1(RSV)), R47.2
SD_C_D2: J5.1 (DAT2(RSV)), R48.2
SD_C_D3: J5.2 (CDDAT3(CS)), R49.2
SD_D0: R46.1, R51.2; also elsewhere on the board
SD_D1: R47.1, R52.2; also elsewhere on the board
SD_D2: R48.1, R53.2; also elsewhere on the board
SD_D3: R49.1, R54.2; also elsewhere on the board
SD_PWR_EN_N: Q1.1 (G), R56.2; also elsewhere on the board
SD_VDD: C82.1, C83.1, J5.4 (VDD), Q1.3 (D)
USB_FS_CONN_DM: R58.2, U14.2 (D1-), U14.9 (NC); also elsewhere on the board
USB_FS_CONN_DP: R57.2, U14.1 (D1+), U14.10 (NC); also elsewhere on the board
USB_FS_DM: R58.1; also elsewhere on the board
USB_FS_DP: R57.1; also elsewhere on the board
USB_HS_DM: U13.2 (D1-), U13.9 (NC); also elsewhere on the board
USB_HS_DP: U13.1 (D1+), U13.10 (NC); also elsewhere on the board
VDDO_4: R50.1, R51.1, R52.1, R53.1, R54.1; also elsewhere on the board

Notes on the sheet:
microSD (slot SDMMC 0, UHS-I)
1 = G, 2 = S, 3 = D ; coupe la carte pour quitter le mode 1,8 V
ESD USB
USB HS : capacite <= 1 pF exigee

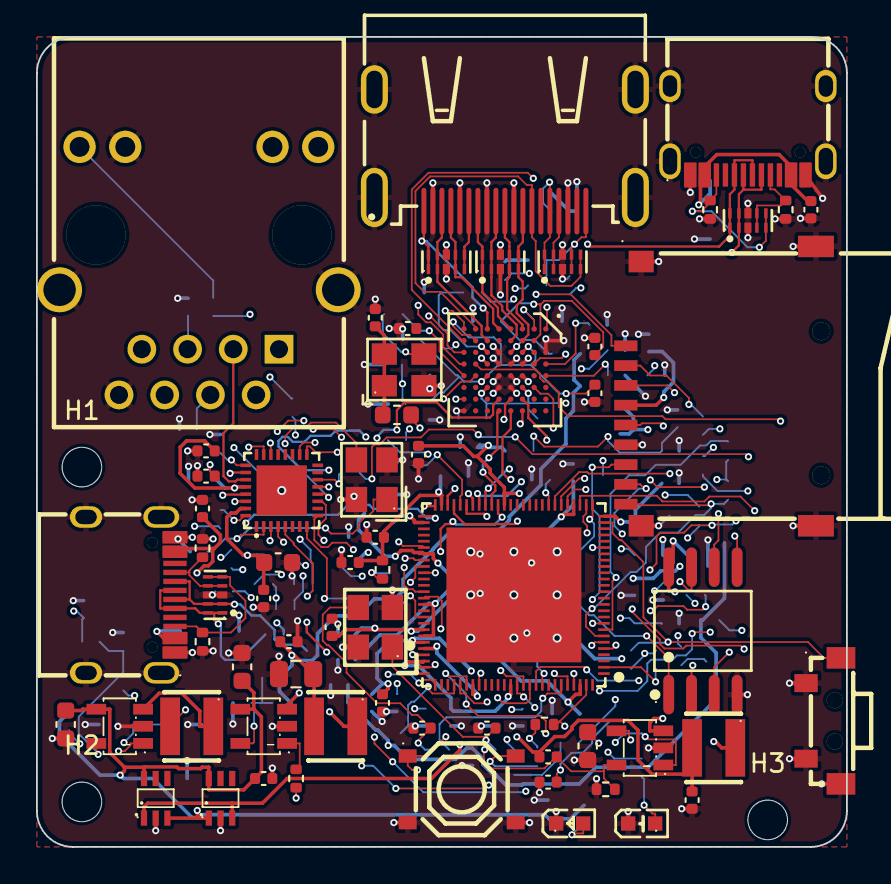
[picture p31: board openkvm.kicad_pcb from above]

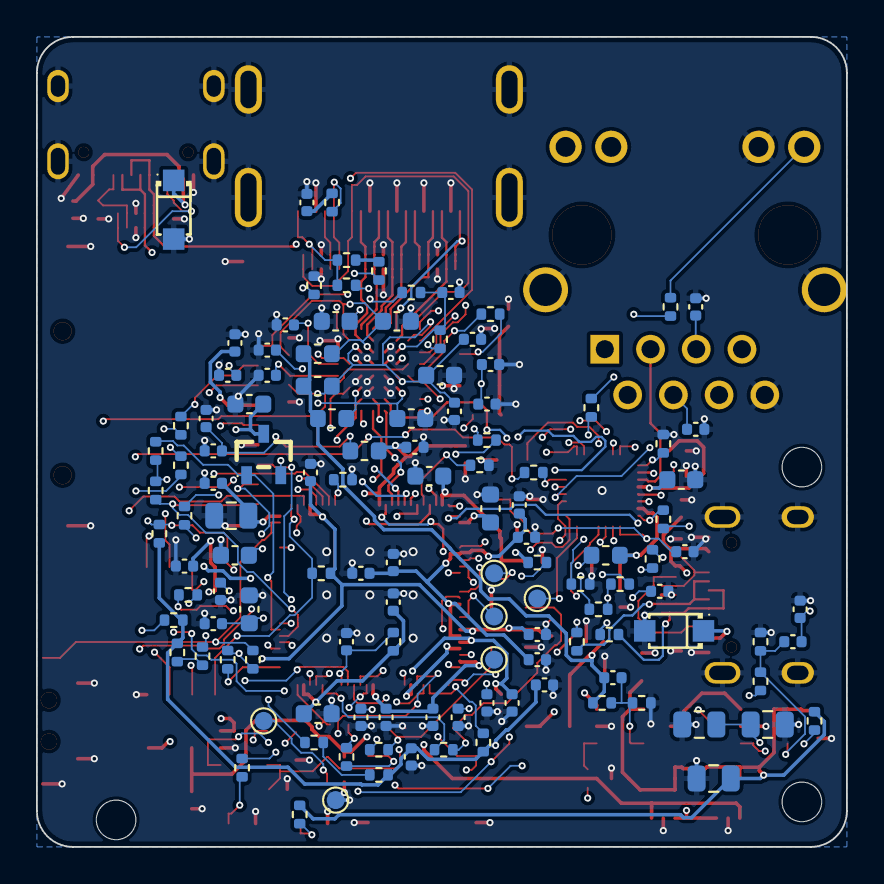
[picture p32: board openkvm.kicad_pcb from below]

Board: 4 copper layers, 45.0 x 45.0 mm, 188 parts (121 on the bottom side), 131 nets.

Other parts of the board:
H1, H2, H3: MountingHole_2.2mm_M2
