gigi74168/openKVM/(commit log)

2026-11-12 docs: record architecture decision (ESP32-P4, 10/100 Ethernet)
    Claude-Session: https://claude.ai/code/session_01ShVLMUvoW4n3w2qyL2EzpT
2026-11-12 docs: add deliverable 1, survey of existing KVM-over-IP devices
    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
2026-11-12 feat: schematic, PCB pre-placement, case concept, licenses and new README
    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
    [composants.csv, eth.kicad_sch, hdmi.kicad_sch, mcu.kicad_sch, netlist.csv, openkvm-boitier-concept.scad, openkvm-bom-jlcpcb.csv, openkvm.kicad_pcb]
2026-11-12 feat: priced BOM (deliverable 5) and 3D models for every component
    - docs/05: BOM costing for 8 and 20 boards, JLCPCB Standard PCBA constraints
    (0.35 mm pitch, 70x70 mm minimum, panel needed), unpriced items listed
    - resolve the three precision resistors (C43251, C25793, C25914), 10k to basic C25744
    - bom_cost.py + dated price snapshot + priced BOM csv
    - 3D: STEP next to the 17 WRL, generated BGA-64 model, oscillator fallback,
    full board STEP/GLB, refreshed renders
    - README and docs/04 updated
    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
    [composants.csv, eth.kicad_sch, hdmi.kicad_sch, mcu.kicad_sch, openkvm-bom-chiffree.csv, openkvm-bom-jlcpcb.csv, openkvm.kicad_pcb, periph.kicad_sch]
2026-11-12 feat!: screenless redesign (no LCD, one button, power + status LEDs)
    - schematic rev 0.2: remove LCD connector J7 and its 6 GPIO, remove second
    side button; add power LED on 5V_SYS and yellow status LED on GPIO6
    (fixes rev 0.1 green LED barely lit from a 3.3 V GPIO)
    - PCB pre-placement: LEDs on the front edge, single FN button, no shorts,
    netlist round-trip 706 pins / 0 difference
    - case concept: solid lid with vents, 2 LED holes, 49.6 x 49.6 x 21.5 mm
    - BOM re-priced (2026-11-12): 34.2-35.7 $/board at 8, 22.0-24.5 $ at 20
    - docs 00-05, README, diagrams, renders, STEP/GLB regenerated
    Claude-Session: https://claude.ai/code/sessio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
    [composants.csv, mcu.kicad_sch, netlist.csv, openkvm-boitier-concept.scad, openkvm-bom-chiffree.csv, openkvm-bom-jlcpcb.csv, openkvm.kicad_pcb, openkvm.kicad_sch]
2026-11-13 wip: two-sided auto-placement, routing pipeline and JLCPCB orientation check
    Work in progress, board not routed yet (autorouter run in progress).
    - place.py + gen_pcb.py: full automatic placement on both sides (188 footprints,
    no courtyard overlap), via keep-outs under U1/U8/U9
    - route.py: JLCPCB rules, net classes, GND/3V3 planes, scripted BGA fan-out,
    Specctra export/import for Freerouting
    - check_orientation.py: compares each footprint with the JLCPCB library one;
    LEDs, SOT-23 and oscillator moved to JLCPCB footprints, yellow LED pin 1 = anode,
    27 MHz oscillator replaced by C390805, debug header replaced by 6 test pads
    - fab.py, check_route.py: Gerber/drill/CPL export and routing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
    [composants.csv, hdmi.kicad_sch, mcu.kicad_sch, netlist.csv, openkvm-bom-jlcpcb.csv, openkvm-place.kicad_pcb, openkvm.kicad_pcb, periph.kicad_sch]
2026-11-13 wip: routing pipeline tuning (no fan-out stage, analytics off, rules saved in project)
    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
    [openkvm-place.kicad_pcb, openkvm.kicad_pcb]
2026-11-13 wip: scripted ground vias, 0.4/0.2 mm vias for JLCPCB hole clearance
    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
    [placement.csv]
2026-11-13 wip: route 3V3 as traces (plane added afterwards), power vias for BGA second ring
    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
    [openkvm.kicad_pcb, placement.csv]
