gigi74168/openKVM/(notices)

Notices in the files:
parts and their libraries:
License: Apache-2.0
